xiaoyangxianshen664/CANopen_IO_Node/项目完成各阶段对应笔记/项目代码运行逻辑.md

# 13：项目代码运行逻辑

当然，我们再把**进入稳定运行后，代码实际上怎样循环**完整串一次。最重要的是：`CanopenTask` 和 `IOTask` 都不会一轮执行完就退出；它们都在 `for (;;)` 中循环，只是每轮会在延时或等待函数里让出 CPU。

### 1：`CanopenTask`每约 1 ms 循环一轮

优先级是 3，最高。每轮依次做四件事：

```c
① 处理 CAN 接收环形队列中的报文
② 有新采样时，取出 {DI, AI1, AI2} 并更新对象字典
③ 推进 Heartbeat 和 PDO 的定时处理
④ DO 值变化时，把 DO 字节放进 io_output_queue
```

随后调用 `vTaskDelayUntil()`，进入阻塞状态，等到下一个约 1 ms 的周期。时间到了，任务变为就绪，调度器安排它继续执行；从延时函数返回后，它回到 `for` 循环开头，开始下一轮。

```
四件事做完 → 延时到下一周期 → 恢复运行 → 回到第一件事
```

因此它是**每约 1 ms 开始新一轮**，不是每 1 ms 重新创建任务。每轮实际执行了多久目前没有测量。

### 2：`IOTask`等待通知或超时，然后继续循环

优先级是 2。每轮开头先清本地变量，再等待：

```
received_flags = 0u;
notified = xTaskNotifyWait(..., pdMS_TO_TICKS(10u));
```

执行到 `xTaskNotifyWait()` 时，若没有 ADC 通知，IOTask 会在这个函数里阻塞，最长 10 ms。之后有两种情况：

```c
//情况1
IOTask 正在运行
    ↓ 调用 xTaskNotifyWait，没有通知
进入阻塞态，等待通知或超时
    ↓ 通知到达 / 10 ms 超时
变为就绪态
    ↓ 调度器分配 CPU
回到运行态，xTaskNotifyWait 返回
    ↓ 
    → 计算对应半区的 AI1/AI2 平均值
    → 读取 DI
    → 把 {DI, AI1, AI2} 覆盖写入 io_sample_queue
	→ 处理DO
	
//情况2
10 ms 超时
    → 等待结束，但没有 ADC 新采样
    → 跳过 AI/DI 采样处理
    → 处理DO
```

两种情况之后都会继续检查 `io_output_queue`，取出 DO 值并调用 `apply_board_do()` 控制 LED。处理完到达 `for` 循环末尾后，**回到循环开头**，再次清零 `received_flags`，再次等待。

所以：

- DMA 半区完成约每 32 ms 通知一次，这是 ADC 数据处理的节奏；
- 10 ms 是一次通知等待的最长时间，超时后也会继续检查 DO 队列；
- `IOTask` 没有固定的 1 ms 或 32 ms 任务周期。

### 3：ADC、DMA 与中断在后台做什么

TIM3 每 1 ms 触发 ADC 扫描 AI1、AI2。CPU 正在执行任务时，ADC 和 DMA 仍由硬件持续工作。

DMA 写满一个半区后产生中断。中断回调通知 IOTask 哪个半区已经完成。**通知会让 IOTask 变为就绪，但不一定马上运行**：如果此时优先级更高的 `CanopenTask` 正在运行，IOTask 要等 CanopenTask 延时或阻塞后再获得 CPU。通知会保留给 IOTask，没能立即运行不等于通知丢失。

### 4：两个低优先级任务

`MonitorTask` 和 `DiagnosticsTask` 优先级都是 1，每约 1 秒执行一次短暂检查，然后各自延时 1 秒。它们没有固定的 CPU 时段；只有优先级 3、2 的任务都没有就绪运行时，才轮到它们。没有就绪任务时，FreeRTOS 运行空闲任务。

Heartbeat 也不是一个独立任务：`CanopenTask` 每轮推进 Heartbeat 计时约 1 ms，默认 `0x1017:00=1000 ms`，计时到期才发送一帧。Node-ID 1 在 Operational 状态时，典型帧是 `0x701`，数据字节 `0x05`。

整体运行关系可以这样记：

```c
CanopenTask：四项协议/I-O协调工作 → 延时 → 回到循环开头
IOTask：等待通知或超时 → 处理 ADC/DI、检查 DO → 回到循环开头
DMA 中断：半区完成时通知 IOTask
Monitor/Diagnostics：低优先级周期检查
```

“通知到达”表示 IOTask 已经就绪；“获得 CPU”还要由调度器根据优先级和当前任务状态决定。

### 5：上位机操作时，代码是怎么执行的

##### 1：上位机发送 `01 01`，节点进入 Operational

这帧应是 **CAN-ID `0x000`，DLC=2，数据 `01 01`**：

```
data[0] = 0x01：NMT Start 命令
data[1] = 0x01：目标节点 Node-ID 1
```

运行路径是：

```c
上位机发送 NMT 帧
    ↓
CAN 硬件收到帧，触发 CAN RX 中断
    ↓
bsp_can.c 的 HAL_CAN_RxFifo0MsgPendingCallback()
    ↓
中断把帧放入软件环形队列，尽快退出
    ↓
CanopenTask 下一轮取出帧
    ↓
dispatch_frame()
    ↓
Canopen_App_NmtReceive()
    ↓
co_nmt_receive()
    ↓
节点状态改为 Operational
```

CAN 接收中断只把帧放进队列，**不在中断里执行 NMT 协议处理**。`CanopenTask` 每约 1 ms 检查接收队列，因此收到帧后会在它下一次取队列时处理。

进入 Operational 后，这轮任务接着调用 `Canopen_App_ProcessPdo(1u)`。PDO 服务发现节点刚进入 Operational，会先发送一次 TPDO1 和 TPDO2，公布当前输入状态。之后才按 PDO 规则处理输入变化和事件周期。

##### 2：按下 KEY1 或 KEY2，DI 如何上报

当前按键映射是：

```c
KEY1 = PA0 → DI bit0
KEY2 = PC13 → DI bit1
```

`Key.h` 标明按键按下为高电平。`read_board_di()` 读到引脚高电平时设置对应位：

```c
KEY1 按下 → DI = 0x01
KEY2 按下 → DI = 0x02
两键都按下 → DI = 0x03
```

不过按键本身**不会直接让 `IO_Task` 运行**。在当前这条代码路径里，`IO_Task` 是由 ADC DMA 半区完成通知唤醒的：

```c
TIM3 每 1 ms 触发 ADC 扫描
    ↓
DMA 写满一个半区，约 32 ms
    ↓
ADC DMA 回调通知 IOTask
    ↓
IOTask 计算 AI1/AI2 平均值，并读取此刻的按键电平
    ↓
把 {DI, AI1, AI2} 写入 io_sample_queue
```

比如你在两次采样之间按下 KEY1，下一次 DMA 半区完成后，`IO_Task` 读到 `DI=0x01`，再把这组 DI/AI 数据交给队列。

之后的路径是：

```c
CanopenTask 取出 io_sample_queue 中的 sample
    ↓
Canopen_App_UpdateInputs(sample.di, sample.ai1, sample.ai2)
    ↓
更新对象字典中的 DI、AI1、AI2
    ↓
Canopen_App_ProcessPdo(1u) 检查输入变化
    ↓
若处于 Operational 且 DI 变化，发送 TPDO1（节点1的 CAN-ID 0x181）
```

所以按键变化是**采样时读到的**，随后被写入对象字典；在 Operational 状态下，PDO 服务再据此决定是否发送 TPDO1。

完整链路：

```c
ADC DMA 回调通知 IOTask
    ↓
IOTask 采到新的 DI
    ↓
CanopenTask 从队列取出采样
    ↓
Canopen_App_UpdateInputs() 更新对象字典
    ↓
CanopenTask 调用 Canopen_App_ProcessPdo(1u)
    ↓
co_pdo_process() 将当前 DI 和上次记录的 last_di 比较
    ↓
DI 有变化且节点处于 Operational → 发送 TPDO1
    
//真正判断 DI 变化并发送 TPDO1 的是Canopen_App_ProcessPdo函数里面调用的 co_pdo_process()
remember_status() 只负责记录错误状态。按下和松开如果都被采样到，通常都会各产生一次 DI 状态变化上报。
```

##### 3：上位机发 DO 数据，让 LED 改变颜色

比如上位机发：

```c
CAN-ID = 0x201
DLC    = 1
DATA   = 0x01
```

`0x201` 是节点 1 的 RPDO1。数据 `0x01` 表示 DO 的 bit0 为 1。接收和执行路径是：

```c
CAN RX 中断将帧放入接收环形队列
    ↓
CanopenTask 取出帧并调用 dispatch_frame()
    ↓
Canopen_App_PdoReceive()
    ↓
co_pdo_receive() 检查节点处于 Operational、DLC 和数据是否合法
    ↓
把 DO 值写入对象字典 0x6200:01
    ↓
CanopenTask 调用 Canopen_App_GetOutputs() 读出 DO
    ↓
DO 值变化，写入 io_output_queue
    ↓
IO_Task 取出 outputs 并调用 apply_board_do()
    ↓
改变 LED GPIO
```

当前 LED 位映射是：

| DO 数据位 | LED  |
| --- | ---- |
| bit0 | 红 |
| bit1 | 绿 |
| bit2 | 蓝 |

LED 是低电平点亮，所以输出位为 1 时，代码传给对应 LED 宏的参数是 0。例如：

```c
DO = 0x01 → 红灯亮
DO = 0x02 → 绿灯亮
DO = 0x04 → 蓝灯亮
DO = 0x05 → 红灯和蓝灯亮
```

另外，`IO_Task` 检查 DO 队列是在等待 ADC 通知之后。它最多等 10 ms 就会继续检查队列，因此 DO 命令到 LED 有一点任务调度延迟；这不是 CAN 中断直接控制灯，而是 `CanopenTask` 更新对象字典，再经队列交给 `IO_Task` 控灯。

这三个动作可以浓缩为：

```c
NMT：CAN 帧 → CAN RX 中断入队 → CanopenTask → NMT 状态变化

按键：ADC DMA 通知 → IOTask 读 DI/AI → 采样队列 → CanopenTask 更新对象字典 → TPDO 上报

DO：RPDO CAN 帧 → CAN RX 中断入队 → CanopenTask 写对象字典 → 输出队列 → IOTask 控制 LED
```

6

## 14：阶段 9 可靠性与 EMCY 故障处理运行逻辑

阶段 8 说明了节点正常运行时，CANopenTask、IOTask、ADC/DMA 和对象字典如何协作。阶段 9 在这条主循环中加入了故障监视、EMCY 上报、安全输出和恢复处理。核心代码位于 `freertos_demo.c` 的 `process_reliability()`，由 `Canopen_Task` 周期调用。

### 1：看门狗何时启动、谁负责刷新

`main()` 完成 HAL、ADC、CAN 等硬件初始化后调用 `BSP_IWDG_Init()`，随后才进入 `freertos_demo()` 创建任务并启动调度器：

```c
main()
    ↓
硬件初始化、CAN_Config()
    ↓
BSP_IWDG_Init()          启动 IWDG
    ↓
freertos_demo()          读取上次复位原因、创建任务、启动调度器
    ↓
Monitor_Task()           检查任务计数，健康时调用 BSP_IWDG_Refresh()
```

当前 IWDG 使用分频系数 64、重装载值 1500，LSI 按约 32 kHz 估算时超时约 3 秒。`Monitor_Task` 每约 1 秒检查一次 `canopen_task_cycle_count` 和 `io_task_cycle_count`；只有两个计数相对上次都发生变化时，才刷新看门狗。若任务停止推进，监视任务不再喂狗，IWDG 超时后复位 MCU。

启动时，`freertos_demo()` 先读取 `RCC_FLAG_IWDGRST`：若上次复位由 IWDG 触发，就置位 `watchdog_reset_pending`；随后清除 RCC 复位原因标志，避免下次启动误读旧记录。`process_reliability()` 会尝试把这条复位记录作为 `CO_EMCY_ERROR_WATCHDOG_RESET` 上报。

### 2：可靠性处理在主循环中的位置

`Canopen_Task` 每轮先处理接收帧并更新 I/O 输入，然后调用 `process_reliability()`，之后再推进 Heartbeat 和 PDO：

```c
CAN RX 队列 → dispatch_frame()
    ↓
取最新 DI/AI 采样并更新对象字典
    ↓
process_reliability()       阶段 9 故障处理
    ↓
ProcessHeartbeat(1 ms)
    ↓
ProcessPdo(1 ms)
    ↓
读取 DO，值变化时交给 IOTask
```

因此可靠性逻辑不是独立任务，而是由优先级较高的 `Canopen_Task` 周期执行。它每次调用只检查一次当前状态；恢复计数每次加一，按 CanopenTask 约 1 ms 的调用节奏近似累计毫秒数。

### 3：故障来源与“新故障”检测

CAN 驱动维护累计计数：

| CAN 驱动计数 | 表示什么 | 可靠性处理用途 |
| --- | --- | --- |
| `can_bus_off_count` | Bus-off 事件累计次数 | 检测新的 Bus-off，并启动接收恢复等待 |
| `can_rx_overflow_count` | 接收软件队列溢出次数 | 检测新的接收溢出 |
| `can_error_count` | HAL CAN 错误累计次数 | 检测新的 CAN 错误 |
| `can_rx_frame_count` | 收到的 CAN 帧累计数 | Bus-off 后确认是否收到新帧 |
| `can_tx_busy_count` | 发送邮箱全忙次数 | 供诊断快照查看；当前 `process_reliability()` 不用它触发故障 |

`observed_*_count` 保存 `process_reliability()` 上次看到的三个错误计数。每轮将当前累计值与它们比较，形成 `new_bus_off`、`new_rx_overflow`、`new_can_error`：计数不同则本轮标志为 1，相同则为 0；比较后再把当前值存回 `observed_*_count`，避免同一次计数变化在后续每轮重复识别。

`freertos_diagnostics_*` 是 `Diagnostics_Task` 每约 1 秒复制的诊断快照，不是 `process_reliability()` 用来发现新故障的比较基准。

### 4：发现故障、进入 EMCY 和安全输出

故障处理大致按以下顺序选择新故障：

```c
看门狗复位待上报
    ↓
新的 Bus-off
    ↓
新的 CAN 接收溢出
    ↓
新的 CAN 错误
    ↓
I/O 采样停滞
```

CAN/ADC 新故障通过 `Canopen_App_ReportEmcy()` 交给 `co_emcy_report()`，组帧并尝试发送。若 CAN 发送暂时失败，EMCY 模块保存 `pending_frame`，后续由 `Canopen_App_ProcessEmcy()` → `co_emcy_process()` 重试。

`reliability_fault_active` 是 FreeRTOS 可靠性流程的本地状态：非零表示正在执行故障处理、安全输出和恢复检查；它不代表 EMCY 帧一定已成功发送，也不等同于 EMCY 模块内部的 `emcy.active`。检测到 Bus-off 时，另外设置 `reliability_wait_for_rx` 并保存 `reliability_rx_baseline`，要求恢复时收到新的 CAN 帧。

活动故障期间的输出路径是：

```c
process_reliability()
    ↓
Canopen_App_SetSafeOutput(1)
    ↓
Canopen_Task 调用 Canopen_App_GetOutputs()
    ↓
安全状态下输出值为 0，写入 io_output_queue
    ↓
IOTask 取出输出值并调用 apply_board_do()
    ↓
真实 LED/DO 进入安全状态
```

每轮故障处理中都会调用 `Canopen_App_ProcessEmcy()`。它只重试 EMCY 模块中确实处于 pending 的帧；若之前的报告帧已成功发送且没有待重试帧，就不会重复发送。

### 5：恢复条件与清除 EMCY

本轮基本健康条件要求：`io_sampling_stalled == 0`，且本轮没有新的 Bus-off、接收溢出或 CAN 错误。若 `reliability_wait_for_rx` 置位，还要求 `can_rx_frame_count` 已高于 Bus-off 时记录的 `reliability_rx_baseline`。此外，节点必须处于 CANopen Operational 状态。

所有条件满足时，`reliability_recovery_ms` 每次调用加一；任何条件中断或节点离开 Operational，计数清零。达到 `FAULT_RECOVERY_STABLE_MS`（当前为 1000）后，调用 `Canopen_App_ClearEmcy()` 尝试发送清除帧。代码认为返回 `CO_OK` 或 `CO_IGNORED` 时清除本地可靠性故障状态，并调用 `Canopen_App_SetSafeOutput(0)` 解除安全输出。

恢复过程可以概括为：

```c
检测新故障
    ↓
报告 EMCY，启动可靠性故障状态
    ↓
强制安全输出，并处理 EMCY 待重试帧
    ↓
I/O、CAN 和 NMT 状态满足健康条件
    ↓
连续稳定计时达到 1000 次调用
    ↓
尝试发送 EMCY 清除帧
    ↓
清除本地故障状态，解除安全输出
```

### 6：阶段9实机验证结果与当前边界

- `Monitor_Task` 已增加首次运行宽限：第一次检查只记录采样基准，不把启动阶段尚未推进的计数判为停滞；之后约每秒更新一次 `io_sampling_stalled`。
- 阶段9使用 `FREERTOS_EMCY_TEST_INJECT_WATCHDOG` 宏做了一次受控看门狗故障注入。测试固件实测收到 `0x081 / 06 FF 01 00 00 00 00 00`，故障期间安全输出生效；进入 Operational 并稳定运行后收到 `0x081 / 00 00 00 00 00 00 00 00`，红灯恢复。随后关闭宏并重新烧录正式固件，正常启动不再自动上报 EMCY。
- 故障上报分支以 `status != CO_ERR_ARGUMENT` 判断是否启动可靠性处理；这不等于 EMCY 帧已经成功发送，发送失败时仍由 `pending_frame` 和 `Canopen_App_ProcessEmcy()` 重试。该主链路已由纯 C 测试和看门狗实机注入验证。
- `co_emcy_clear()` 在清除帧已处于 pending 时返回 `CO_IGNORED`，当前 `process_reliability()` 将 `CO_IGNORED` 也作为清除完成处理；清除帧失败重试的协议状态已在纯 C 测试覆盖，但该安全输出边界仍是后续可改进项。
- `reliability_recovery_ms` 是按任务调用次数计数，不是硬件定时器测得的精确毫秒数；`Canopen_Task` 延迟或超期时，实际稳定时间会有偏差。
- `process_reliability()` 通过优先级分支一次选择一种新故障；当前没有同时保存多个独立故障的故障队列。Bus-off、FIFO 溢出和 ADC 停滞没有通过破坏硬件逐项注入，属于阶段10可继续扩展的异常验收项。
