xiaoyangxianshen664/CANopen_IO_Node/项目完成各阶段对应笔记/阶段5/阶段5（sdo_.h）.md

# 解析：

这些 `#define` 是阶段 5 的 **SDO 固定常量**，用于统一表示响应 CAN-ID 和各类 SDO 命令字。

### 1：第一个宏定义

```c
#define CO_COB_SDO_TX_BASE UINT32_C(0x580)	//CO_COB_SDO_TX_BASE = 0x580
```

这是 SDO 响应的基准 COB-ID。

SDO 响应 CAN-ID 的计算方式是：

```
0x580 + Node-ID
```

例如：

```
Node-ID = 1 → 响应 ID = 0x581
Node-ID = 2 → 响应 ID = 0x582
Node-ID = 127 → 响应 ID = 0x5FF
```

代码中：

```
response.id = CO_COB_SDO_TX_BASE + sdo->node->node_id;
```

也就是：

```
response.id = 0x580 + node_id;
```

阶段 1 已经定义了 SDO 请求基准：

```
#define CO_COB_SDO_RX_BASE UINT32_C(0x600)
```

因此 SDO 的方向是：

```
主站 → 节点：0x600 + Node-ID
节点 → 主站：0x580 + Node-ID
```

Node-ID 为 1 时：

```
请求：0x601
响应：0x581
```

`UINT32_C(0x580)` 用于明确把常量写成适合 `uint32_t` 的整数类型。

### 2：读取请求

```c
#define CO_SDO_CMD_UPLOAD 0x40u	//主站请求节点读取一个对象。
```

例如主站读取：

```
0x1017:00
```

请求帧数据：

```
40 17 10 00 00 00 00 00
```

其中：

```
40       读取请求
17 10    Index = 0x1017，小端排列
00       Sub-index = 0x00
后四字节 读取请求没有携带对象数据，填 0
```

这里的 Upload 可以理解为：

```c
节点把对象数据“上传”给主站
```

### 3：写入请求

Download 表示：

> 主站把数据写入节点对象。

四个命令分别对应写入 1～4 个有效数据字节：

```c
#define CO_SDO_CMD_DOWNLOAD_1 0x2Fu
#define CO_SDO_CMD_DOWNLOAD_2 0x2Bu
#define CO_SDO_CMD_DOWNLOAD_3 0x27u
#define CO_SDO_CMD_DOWNLOAD_4 0x23u
```

对应关系：

| 命令字 | 写入有效数据长度 |
| --- | --- |
| `0x2F` | 1 字节 |
| `0x2B` | 2 字节 |
| `0x27` | 3 字节 |
| `0x23` | 4 字节 |

例如写入：

```
0x1017:00 = 500
```

500 的小端字节是：

```
F4 01
```

请求帧为：

```
2B 17 10 00 F4 01 00 00
```

含义：

```c
2B       写入 2 字节
17 10    Index = 0x1017
00       Sub-index = 0
F4 01    有效数据 500
00 00    剩余填充字节
```

为什么 `0x2B` 表示 2 字节，可以简单记忆为：

```c
0x2F → 1 字节
0x2B → 2 字节
0x27 → 3 字节
0x23 → 4 字节
```

这些命令字不仅表示“这是 Download”，还告诉服务层本次提供了几个有效数据字节。`co_sdo_receive()` 中就是通过它们设置：

```c
requested_length = 1u;
requested_length = 2u;
requested_length = 3u;
requested_length = 4u;
```

然后和对象条目的真实长度比较。

### 4：读取成功响应

```c
#define CO_SDO_CMD_UPLOAD_1 0x4Fu
#define CO_SDO_CMD_UPLOAD_2 0x4Bu
#define CO_SDO_CMD_UPLOAD_3 0x47u
#define CO_SDO_CMD_UPLOAD_4 0x43u
```

这些命令表示：

> 节点读取对象成功，并返回 1～4 个字节。

对应关系：

| 响应命令字 | 返回有效数据长度 |
| --- | --- |
| `0x4F` | 1 字节 |
| `0x4B` | 2 字节 |
| `0x47` | 3 字节 |
| `0x43` | 4 字节 |

例如读取：

```
0x1017:00 = 1000
```

1000 的小端形式是：

```
E8 03
```

响应帧：

```
4B 17 10 00 E8 03 00 00
```

含义：

```
4B       读取成功，返回 2 字节
17 10    Index = 0x1017
00       Sub-index = 0
E8 03    返回值 1000
00 00    未使用位置填 0
```

代码中通过对象长度选择响应命令：

```
response.data[0] = upload_command(entry->length);
```

如果对象长度是：

```
1 → 0x4F
2 → 0x4B
3 → 0x47
4 → 0x43
```

例如：

```
0x6200:01 是 UNSIGNED8，长度 1
```

读取响应命令就是：

```
0x4F
```

而：

```
0x1017:00 是 UNSIGNED16，长度 2
```

读取响应命令就是：

```
0x4B
```

### 5：写入成功响应

```c
#define CO_SDO_CMD_DOWNLOAD_OK 0x60u
```

`0x60` 表示：

> 主站写入对象成功，节点已经接受并完成写入。

例如主站写入 `0x1017:00 = 500`：

请求：

```
2B 17 10 00 F4 01 00 00
```

成功响应：

```
60 17 10 00 00 00 00 00
```

`0x60` 后面的 Index 和 Sub-index 用于说明这是对哪个对象的响应，后四字节没有额外数据，因此填 0。

### 6. Abort 响应

```
#define CO_SDO_CMD_ABORT 0x80u
```

`0x80` 表示：

> 本次 SDO 操作失败，后面跟随 4 字节 Abort 错误码。

例如读取不存在的对象：

```
0x9999:00
```

响应可能是：

```
80 99 99 00 00 00 02 06
```

拆开看：

```
80          Abort 命令字
99 99       Index = 0x9999
00          Sub-index = 0
00 00 02 06 Abort code = 0x06020000
```

因为错误码也按小端排列：

```
0x06020000 → 00 00 02 06
```

常见错误码包括：

```
0x06020000：Index 不存在
0x06090011：Sub-index 不存在
0x06010002：对象只读，不能写
0x06070012：数据过长
0x06070013：数据过短
0x06090030：值超出允许范围
0x08000022：当前 NMT 状态不允许
```

所以：

```
0x80
```

只是说明“失败”，真正的原因在后面的 4 字节 Abort code 中。

### 7. 这些宏在代码中的整体关系

```
主站发送请求
    │
    ├── 0x40：读取对象
    ├── 0x2F：写 1 字节
    ├── 0x2B：写 2 字节
    ├── 0x27：写 3 字节
    └── 0x23：写 4 字节
    │
    ▼
节点解析并访问对象字典
    │
    ├── 读取成功
    │      ├── 0x4F：返回 1 字节
    │      ├── 0x4B：返回 2 字节
    │      ├── 0x47：返回 3 字节
    │      └── 0x43：返回 4 字节
    │
    ├── 写入成功
    │      └── 0x60
    │
    └── 操作失败
           └── 0x80 + Abort code
```

可以用一句话记忆：

```
0x40 是读请求；
0x2F/2B/27/23 是按长度区分的写请求；
0x4F/4B/47/43 是按长度区分的读成功响应；
0x60 是写成功；
0x80 是 Abort 失败响应。
```

这些宏本身不会发送报文，也不会访问对象。它们只是把协议中固定的数字命令定义成有名字的常量，让 `co_sdo.c` 里的逻辑更容易阅读和维护。

# 结构体

```c
typedef struct
{
    co_context_t *node;
    co_device_od_t *device;
} co_sdo_t;
```

它本身只是定义类型，真正的变量由调用者创建，例如测试中的：

```
co_sdo_t sdo = {0};
```

之后通过：

```
co_sdo_init(&sdo, &node, &device);
```

完成绑定。

## 1. `co_context_t *node`的作用

```
co_context_t *node;
```

这是指向节点上下文的指针。

例如：

```
co_context_t node = {0};
co_sdo_t sdo = {0};

co_sdo_init(&sdo, &node, &device);
```

初始化后：sdo.node ─────► node

```c
co_status_t co_sdo_init(co_sdo_t *sdo,
                        co_context_t *node,
                        co_device_od_t *device)
{
    co_sdo_t candidate = {node, device};
    co_status_t status;

    if (sdo == NULL)
        return CO_ERR_ARGUMENT;

    status = validate(&candidate);
    if (status != CO_OK)
        return status;

    *sdo = candidate;
    return CO_OK;
}

先看测试中创建的三个实际变量：
co_context_t node = {0};
co_device_od_t device = {0};
co_sdo_t sdo = {0};
它们分别是：
node    一个实际的节点结构体变量
device  一个实际的设备对象字典变量
sdo     一个实际的 SDO 结构体变量

然后调用：
co_sdo_init(&sdo, &node, &device);
这里传入的是三个地址：
    
&sdo    				sdo 变量的地址
&node   			    node 变量的地址
&device                  device 变量的地址

所以函数参数实际对应：
co_sdo_t        *sdo   = &sdo;
co_context_t    *node  = &node;
co_device_od_t  *device = &device;

可以先忽略类型，只看名字：
sdo    参数 → 指向外面的 sdo 变量
node   参数 → 指向外面的 node 变量
device 参数 → 指向外面的 device 变量

第一步：创建临时的 candidate
co_sdo_t candidate = {node, device};
co_sdo_t 结构体有两个成员：

 typedef struct
{
    co_context_t *node;
    co_device_od_t *device;
} co_sdo_t;
所以这句等价于：
co_sdo_t candidate;

candidate.node = node;
candidate.device = device;
而函数参数中的：
node   实际是 &node
device 实际是 &device
所以最终就是：
candidate.node   = &node;
candidate.device = &device;
此时关系是：
candidate
├── node   ─────► 外面的 node 变量
└── device ────► 外面的 device 变量
    
//bb 那么多话，其实就是传的实参node 是一个地址指针，node 存的东西是node=&node，这jb codex 这么写代码也是神了
co_sdo_t 结构体两个子变量就是存指针，
分别存的&node 和&device 呗
```

它让 SDO 服务能够访问：

```
node->node_id
node->state
node->tx
node->tx_user
```

##### 用于计算响应 CAN-ID

SDO 响应的 CAN-ID 是：

```
0x580 + Node-ID
```

代码中：

```
response.id = CO_COB_SDO_TX_BASE + sdo->node->node_id;
```

假设：

```
Node-ID = 1
```

响应 ID 就是：

```
0x580 + 1 = 0x581
```

假设：

```
Node-ID = 2
```

响应 ID 就是：

```
0x580 + 2 = 0x582
```

因此 SDO Server 不需要固定写死 `0x581`，而是通过 `node` 指针读取当前节点号。

##### 用于状态门控

SDO 是否处理，还要看当前 NMT 状态：

```
if (kind != CO_RX_SDO || !active(sdo->node->state))
    return CO_IGNORED;
```

`active()` 只允许：

```
CO_NMT_PRE_OPERATIONAL
CO_NMT_OPERATIONAL
```

因此：

```
Initialization → 忽略 SDO
Pre-operational → 处理 SDO
Operational → 处理 SDO
Stopped → 忽略 SDO
```

这体现了 `node` 指针的第二个作用：

> SDO 根据节点当前 NMT 状态决定是否提供服务。

##### 用于发送响应

生成响应帧后：

```
return co_send(sdo->node, &response);
```

这里通过节点上下文调用阶段 1 的统一发送入口，最终进入：

```
node->tx(node->tx_user, &response)
```

所以 `node` 把阶段 5 SDO 和阶段 1 的发送机制连接起来。

## 2. `co_device_od_t *device`的作用

```
co_device_od_t *device;
```

这是指向设备对象字典的指针。

例如：

```
co_device_od_t device = {0};
co_sdo_t sdo = {0};

co_sdo_init(&sdo, &node, &device);
```

初始化后：

```
sdo.device ─────► device
```

它让 SDO 服务可以通过对象字典查找和访问对象。

##### 用于查找对象

收到请求后，SDO 从报文中解析：

```
Index
Sub-index
```

然后调用：

```
co_od_find(&device->table, index, subindex, &entry);
```

在 SDO 代码中实际通过：

```
find_entry(sdo->device, index, subindex, &entry, &abort_code);
```

查找例如：

```
0x1017:00
0x6200:01
0x6401:01
```

找到后：

```
entry ─────► 对象条目
```

##### 用于读取对象

Upload 请求 `0x40` 找到对象后：

```
status = co_od_read(entry, data, entry->length);
```

对象层通过条目的回调，把当前对象值读入：

```
uint8_t data[4];
```

例如：

```
0x1017:00 = 1000
```

读取后：

```
data[0] = 0xE8
data[1] = 0x03
```

然后 SDO 将这些字节放入响应帧。

##### 用于写入对象

Download 请求找到对象后：

```
status = co_od_write(entry,
                     sdo->node->state,
                     request->data + 4u,
                     requested_length);
```

这里把：

```
请求帧 Data[4..7]
```

作为对象数据交给阶段 2 的对象写入层。

例如：

```
请求：
2B 17 10 00 F4 01 00 00
```

传给对象层的是：

```
request->data + 4
    ↓
F4 01
```

对象层最终把它写入：

```
0x1017:00 = 500
```

##### 用于把内部错误转换为 Abort

对象层返回的是内部状态：

```
CO_ERR_OD_NOT_FOUND
CO_ERR_OD_READ_ONLY
CO_ERR_OD_LENGTH
CO_ERR_OD_VALUE
CO_ERR_OD_STATE
```

SDO 服务再把它们转换为 CANopen Abort 码：

```
CO_ERR_OD_NOT_FOUND → 0x06020000
CO_ERR_OD_READ_ONLY → 0x06010002
CO_ERR_OD_LENGTH    → 0x06070010 / 12 / 13
CO_ERR_OD_VALUE     → 0x06090030
CO_ERR_OD_STATE     → 0x08000022
```

所以：

```
阶段 2：返回程序内部错误状态
阶段 5：把内部错误包装成 SDO Abort 响应
```
