xiaoyangxianshen664/CANopen_IO_Node/项目完成各阶段对应笔记/阶段9/canopen_app状态机.md

# 一、先抓住 `canopen_app.c` 的本质

你可以把它理解成：

```c
                 CanopenTask / IO_Task
                         │
                         ▼
                ┌─────────────────┐
                │  canopen_app.c  │
                │   应用层接口     │
                └────────┬────────┘
                         │
             转交给纯 C CANopen 模块
                         │
        ┌────────────────┼────────────────┐
        ▼                ▼                ▼
      co_nmt           co_sdo            co_pdo
        │                │                │
     节点状态          对象字典          PDO通信
                         
                         │
                         ▼
                      co_hb
                      co_emcy
```

所以最重要的一句话就是：

> `canopen_app.c` 自己不是 CANopen 协议核心，它主要负责“把协议层的事情交给对应的 `BSP层` 模块”。

# 二、5 类函数，其实可以进一步压成 5 个动作

你原来的分类非常好，我建议最终记成：

```c
① Init       —— 建立
② Receive    —— 接收
③ Process    —— 推进
④ Update/Get —— 搬运数据
⑤ Report/Clear —— 故障处理
```

------

### ① Init：把整个系统接起来

```c
Canopen_App_Init()
```

它做的是：

```c
node
device
nmt
heartbeat
sdo
pdo
emcy
   ↓
全部初始化
   ↓
CANopen 节点准备运行
```

所以看到：

```
Init
```

就想到：

> **“把所有 CANopen 模块组装起来。”**

# 三、 Receive：主站发东西过来

这里非常重要，因为三个 Receive 可以用**主站发什么**来记。

```v
主站
 │
 ├── NMT ──→ NmtReceive
 │
 ├── SDO ──→ SdoReceive
 │
 └── RPDO ─→ PdoReceive
```

### NMT

```v
Canopen_App_NmtReceive()
        ↓
co_nmt_receive()
        ↓
node.state
```

一句话：

> **NMT = 改节点状态**

------

### SDO

```c
Canopen_App_SdoReceive()
        ↓
co_sdo_receive()
        ↓
对象字典
        ↓
SDO Response
```

一句话：

> **SDO = 主站访问对象字典**

------

### RPDO

```c
Canopen_App_PdoReceive()
        ↓
co_pdo_receive()
        ↓
0x6200:01
```

一句话：

> **RPDO = 主站下发输出数据**

所以三个 Receive 不要死背：

```c
NMT → 主机要求nmt状态改变
SDO → 主机访问字典读取值DI，AI1,AI2
RPDO → 主机输出DO至字典
```

# 四、 Process：不是“收到东西”，而是“时间到了，该干活了”

这是和 Receive 最容易混淆的地方。

### Heartbeat

```c
Canopen_App_ProcessHeartbeat(1u)
```

本质：

```c
时间推进
   ↓
Heartbeat 定时器
   ↓
到期？
   ↓
发送 0x700 + Node-ID
```

所以：

> **Heartbeat Process = 推进心跳定时器。**

------

### PDO

```
Canopen_App_ProcessPdo(1u)
```

本质：

```c
对象字典中的 DI/AI
        ↓
有没有变化？
有没有到周期？
        ↓
决定是否发送 TPDO
```

所以：

> **PDO Process = 推进 PDO 处理，并决定要不要上报输入。**

------

因此：

```c
Receive
    ↓
“别人发东西给我”

Process
    ↓
“我自己周期性检查该做什么”
```

这个区别一定要记住。

# 五、Update / Get：数据搬运桥

这个其实是整个应用层最容易理解的一组。

### UpdateInputs

```c
真实硬件
   │
   │ IO_Task
   ▼
DI / AI
   │
   ▼
Canopen_App_UpdateInputs()
   │
   ▼
对象字典
```

对应：

```c
DI  → 0x6000:01
AI1 → 0x6401:01
AI2 → 0x6401:02
```

注意：

> **UpdateInputs 只是更新数据，不负责发送 TPDO。**

之后：

```
UpdateInputs()
      ↓
ProcessPdo()
      ↓
决定是否 TPDO
```

这两个函数要绑定记忆。

------

### GetOutputs

方向刚好反过来：

```c
对象字典
   ↓
GetOutputs()
   ↓
outputs
   ↓
io_output_queue
   ↓
IO_Task
   ↓
真实 DO
```

所以：

```c
UpdateInputs = 外部 → CANopen

GetOutputs   = CANopen → 外部
```

这是非常漂亮的一对：

> **Input 是“写进去”，Output 是“拿出来”。**

# 六、 EMCY：故障三件套

这里你其实已经理解得很好。

直接记：

```c
Report
   ↓
新故障

Clear
   ↓
故障恢复

Process
   ↓
发送失败，重试
```

即：

```c
Canopen_App_ReportEmcy()
        ↓
co_emcy_report()

Canopen_App_ClearEmcy()
        ↓
co_emcy_clear()

Canopen_App_ProcessEmcy()
        ↓
co_emcy_process()
```

最关键的区别：

### Report 不负责“发现故障”

而是：

```c
其他模块发现故障
        ↓
ReportEmcy()
        ↓
EMCY 模块组装报文
        ↓
发送
```

### Clear 不负责“判断是否恢复”

而是：

```c
外部可靠性逻辑判断已经恢复
        ↓
ClearEmcy()
```

### Process 不负责“产生故障”

它只是：

```c
pending=1时
 ↓
重新发送
```

# 七、把整个 `canopen_app.c` 串起来

现在可以把它压缩成下面这一张图：

```c
                     CANopen_App
                          │
       ┌──────────────────┼──────────────────┐
       │                  │                  │
      主站                周期任务             硬件
       │                  │                  │
       ▼                  ▼                  ▼
   Receive              Process          UpdateInputs
       │                  │                  │
 ┌─────┼─────┐       ┌────┴────┐            │
 ▼     ▼     ▼       ▼         ▼            ▼
NMT   SDO   RPDO   Heartbeat   PDO        DI / AI
 │     │     │       │         │            │
 ▼     ▼     ▼       ▼         ▼            ▼
状态  字典   DO     心跳       TPDO       对象字典
                                              │
                                              ▼
                                         ProcessPdo
                                              │
                                              ▼
                                             TPDO

对象字典
    │
    ▼
GetOutputs()
    │
    ▼
DO
    │
    ▼
IO_Task
    │
    ▼
真实硬件

故障
 │
 ├── ReportEmcy()
 │
 ├── ProcessEmcy()
 │
 └── ClearEmcy()
```

# 八、最后给你一个真正适合背的版本

以后你重新打开 `canopen_app.c`，脑子里只需要先出现：

```c
canopen_app.c
│
├── Init
│   └── 初始化节点、对象字典和各协议模块，发送 Boot-up
│
├── Receive：处理主站发来的报文
│   ├── NMT  → 改变节点状态
│   ├── SDO  → 读写对象字典
│   └── RPDO → 写入 DO 对象
│
├── Process：推进协议服务
│   ├── Heartbeat → 到期时发送当前 NMT 状态
│   └── PDO       → 检查变化/周期，发送 TPDO
│
├── Data Bridge：连接真实 I/O 和对象字典
│   ├── UpdateInputs → DI/AI 写入对象字典
│   └── GetOutputs   → 从对象字典读取 DO；故障或非 Operational 时返回安全值DO恒为0
│
└── EMCY：故障处理接口
    ├── Report  → 报告新故障
    ├── Clear   → 报告故障已恢复
    └── Process → 重试发送失败的 EMCY 帧
特别是输出方向要连着理解：RPDO 先更新 DO 对象，GetOutputs 再取出 DO 值交给 FreeRTOS 任务输出到 GPIO。
```

然后再加一条**最核心的方向感**：

```c
主站 → 节点
NMT / SDO / RPDO
        ↓
     Receive

//按按键或者拧电位器
硬件 → CANopen
DI / AI
  ↓
UpdateInputs
  ↓
对象字典
  ↓
ProcessPdo
  ↓
TPDO
  ↓
主站

//can上位机下发东西
主站 → CANopen → 硬件
RPDO
 ↓
PdoReceive
 ↓
对象字典
 ↓
GetOutputs
 ↓
IO_Task
 ↓
DO
```
