xiaoyangxianshen664/CANopen_IO_Node/项目完成各阶段对应笔记/阶段5/阶段5.md

阶段 5 的首版代码已经写完，并创建了本地分支：

```
stage5-sdo
```

新增：

- [co_sdo.h](C:/Users/lolbo/CANopen_IO_Node/canopen/include/co_sdo.h)
- [co_sdo.c](C:/Users/lolbo/CANopen_IO_Node/canopen/src/co_sdo.c)
- [test_co_sdo.c](C:/Users/lolbo/CANopen_IO_Node/tests/test_co_sdo.c)

更新：

- [canopen/CMakeLists.txt](C:/Users/lolbo/CANopen_IO_Node/canopen/CMakeLists.txt)
- [tests/CMakeLists.txt](C:/Users/lolbo/CANopen_IO_Node/tests/CMakeLists.txt)

当前实现包括：

```
SDO 请求：0x600 + Node-ID
SDO 响应：0x580 + Node-ID
固定 DLC：8
Upload：0x40
Download：0x2F / 0x2B / 0x27 / 0x23
Upload 响应：0x4F / 0x4B / 0x47 / 0x43
Download 成功：0x60
Abort：0x80 + 4 字节错误码
```

已覆盖：

- 读取 `0x1017:00`；
- 写入 `0x1017:00`；
- 不存在的 Index；
- 存在 Index 但不存在的 Sub-index；
- 只读对象写入；
- 数据长度过短；
- BOOLEAN 非法值；
- 不支持的命令；
- Initialization/Stopped 状态忽略 SDO；
- 错误 Abort 码按小端返回；
- 通过阶段 1 的 `co_send()` 发送响应。

验证结果：

```
cmake --build build                         通过
ctest --test-dir build --output-on-failure  14/14 通过
git diff --check                            通过
```

我暂时没有创建 commit，因为我们之前约定是先把当前阶段的 `.c/.h` 和测试全部写完并验证，再按源码主线学习，最后更新笔记并提交。当前无关的 `pelican-bicycle-animation.html` 仍未纳入修改。
