xiaoyangxianshen664/CANopen_IO_Node/项目完成各阶段对应笔记/阶段4/阶段4.md

```
当前实现覆盖：
- 从 0x1017:00 读取 Heartbeat 周期；
- 周期为 0 时关闭 Heartbeat；
- 到期发送 0x700 + Node-ID；
- DLC 为 1；
- 数据字节为当前 NMT 状态；
- Initialization 状态不发送周期 Heartbeat，避免把 Boot-up 的 0x00 当作普通心跳；
- 发送失败后保留到期状态，下一次可重试；
- 同值重写 0x1017 也会重新开始计时；
- 保留周期余量，避免计时漂移。
```
