xiaoyangxianshen664/CANopen_IO_Node/项目完成各阶段对应笔记/阶段2/阶段2（co_od.h）.md

# 解析

### 1：第一个枚举

```c
typedef enum {
    CO_OD_UNSIGNED8 = 1, /* 无符号 8 位整数，占 1 字节 */
    CO_OD_UNSIGNED16 = 2, /* 无符号 16 位整数，占 2 字节 */
    CO_OD_UNSIGNED32 = 4 /* 无符号 32 位整数，占 4 字节 */
} co_od_type_t;
```

这是定义一个枚举类型，用来描述对象字典中的无符号整数类型。

```c
co_od_type_t		//是这个枚举类型的名字。
```

三个枚举成员分别表示：

| 枚举值 | 含义 | 占用字节数 |
| --- | --- | --- |
| `CO_OD_UNSIGNED8`  | UNSIGNED8  | 1 |
| `CO_OD_UNSIGNED16` | UNSIGNED16 | 2 |
| `CO_OD_UNSIGNED32` | UNSIGNED32 | 4 |

这里的数值：

```
1、2、4
```

是我们有意设置的，直接对应该类型需要的**字节数**。

例如对象条目中：

```
.type = CO_OD_UNSIGNED16
```

表示这个对象使用 `UNSIGNED16` 类型。

后面程序就可以根据这个枚举值判断它应该占几个字节：

```
CO_OD_UNSIGNED8  → 1 字节
CO_OD_UNSIGNED16 → 2 字节
CO_OD_UNSIGNED32 → 4 字节
```

要注意，`CO_OD_UNSIGNED16` 不是 C 语言真正的 `uint16_t` 变量，它只是一个**类型描述标记**。

真正的数据变量可能是：

```
uint16_t analog_input;
```

而对象条目中的：

```
CO_OD_UNSIGNED16
```

只是告诉对象字典：

```
这个对象按照 UNSIGNED16 解释，占 2 字节。
```

例如：

```
co_od_type_t type = CO_OD_UNSIGNED16;
```

此时：

```
type 保存的是类型描述
实际数值仍然需要由读取回调提供
```

所以这组枚举解决的是：

```
对象是什么数据类型？
对象应占多少字节？
```

暂时不涉及对象当前具体保存的数值。

### 2：第二个枚举

```c
typedef enum {
    CO_OD_READ_ONLY = 0,
    CO_OD_READ_WRITE = 1
} co_od_access_t;
```

这个枚举描述对象字典的**访问权限**。

```c
co_od_access_t		//是枚举类型名称。
```

两个成员含义：

#### CO_OD_READ_ONLY = 0

```
CO_OD_READ_ONLY = 0
```

表示只读：

```c
主站can上位机可以读取对象
主站can上位机不能通过对象字典写入对象
```

例如：

```
0x6000:01 数字输入
0x6401:01 AI1
```

这些数据由 STM32 的输入引脚或 ADC 更新，主站只能读取。

#### CO_OD_READ_WRITE = 1

表示可读写：

```
主站可以读取对象
主站也可以通过对象字典写入对象
```

例如：

```
0x6200:01 数字输出命令
0x1017:00 心跳周期
```

主站可以写入新的值，协议层再通过写回调交给应用层处理。

这里的 `0` 和 `1` 只是权限标记：

```
0 → 只读
1 → 可读写
```

它们不是 CAN 报文中的数据，也不是对象当前保存的数值。

例如：

```
co_od_access_t access = CO_OD_READ_ONLY;
```

表示这个变量描述的是：

```
该对象允许怎样访问
```

后面对象条目会通过成员保存这个权限：

```
entry.access
```

当调用写入函数时，程序会检查：

```
if (entry->access != CO_OD_READ_WRITE)
```

如果对象是 `CO_OD_READ_ONLY`，就拒绝写入，并返回：

```
CO_ERR_OD_READ_ONLY
```

所以这个枚举解决的是：

```
这个对象允许主站读写，还是只能读取？
```

### 3：读（回调函数指针）

```c
typedef co_status_t (*co_od_read_fn)(
    void *user,
    uint8_t *data,
    uint8_t length
);
```

它表示：凡是符合这个参数和返回值形式的函数，都可以作为对象的读取函数。

拆开看：

```c
co_status_t
```

表示回调执行后返回一个状态，例如：

```c
CO_OK
CO_ERR_ARGUMENT
(*co_od_read_fn)
```

表示 `co_od_read_fn` 是一个**函数指针类型**。

```
void *user
```

是回调使用的辅助数据地址。

例如对象值可能保存在某个应用变量中，或者需要通过硬件读取。对象字典本身不直接知道这些数据在哪里，就通过 `user` 把相关对象地址传给回调。

```
uint8_t *data
```

是输出数据缓冲区的地址。

读取回调要把对象当前值写进这里。例如 AI1 当前值是：

```
0x1234
```

按照 CANopen 小端顺序写入：

```
data[0] = 0x34
data[1] = 0x12

```

uint8_t length表示这次要写入多少个字节。

例如：

```
UNSIGNED8  → length = 1
UNSIGNED16 → length = 2
UNSIGNED32 → length = 4
```

一个符合它的读取函数可以是：

```c
static co_status_t my_read(void *user,
                           uint8_t *data,
                           uint8_t length)
{
    /* 把对象当前值写入 data */
    return CO_OK;
}
```

### 4：写（回调函数指针）

```c
typedef co_status_t (*co_od_write_fn)(
    void *user,
    const uint8_t *data,
    uint8_t length
);
```

它和读取回调很相似，但 `data` 前面多了：

```
const
```

这里的 `data` 是主站传进来的写入数据，回调只应该读取它，不能修改它。

例如主站要把数字输出写成：

```
0x05
```

对象字典完成检查后调用写回调：

```
write(user, data, 1);
```

写回调读取：

```
data[0] == 0x05
```

然后把这个值交给应用层，控制对应的 DO。

### 5：两个回调的区别

##### 1：区别

这两个回调的方向可以这样记：

```c
读取对象：

应用层当前值
      ↓
read 回调
      ↓
data 缓冲区
      ↓
后续 SDO/PDO 使用

    写入对象：

主站数据
      ↓
data 缓冲区
      ↓
对象字典检查
      ↓
write 回调
      ↓
应用层变量或硬件
```

它们的区别是：

| 回调 | `data` 作用  | 是否允许回调修改 |
| --- | --- | --- |
| `co_od_read_fn`  | 输出缓冲区 | 可以写入 |
| `co_od_write_fn` | 主站输入数据 | 不可以修改 |

所以这两个函数指针类型的目的，是让对象字典只负责：

```
查找对象、检查权限、检查长度和数值
```

具体数据从哪里读取、写入哪个应用变量，则交给外部回调完成。

##### 2：补充

这两个都是**函数指针类型**，但有两点需要修正。

**读取回调：**

```c
typedef co_status_t (*co_od_read_fn)(
    void *user,
    uint8_t *data,
    uint8_t length
);
```

它用于读取 STM32 当前对象值，例如：

```
PA0～PA3 → 数字输入对象
PC0/PC1 → AI 对象
```

执行读取回调时，回调函数把当前值写入 `data`：

```c
STM32 当前数据
    ↓
读取回调
    ↓
data 缓冲区
    ↓
SDO 或 PDO
```

这里 `data` 可以修改的说法，是因为它是**输出缓冲区**。对象值会随着输入变化，所以每次读取时都可能得到不同的数据，所以说可修改，是指的是缓存区的内容可以修改。

**写入回调：**

```
typedef co_status_t (*co_od_write_fn)(
    void *user,
    const uint8_t *data,
    uint8_t length
);
```

它用于把主站写入对象的数据交给应用层，例如：

```c
主站写入 0x6200:01
    ↓
对象字典检查
    ↓
写入回调
    ↓
STM32 更新 DO 输出
```

`const uint8_t *data` 中的 `const` 表示：

```
回调可以读取主站发送的数据
回调不能修改 data 缓冲区本身
```

例如主站发送：

```
data[0] = 0x05
```

回调可以读取 `0x05`，然后让应用层控制对应输出，但不能把 `data[0]` 改成别的值。

不过“主机发送什么就原样写入”还要加一个前提：对象字典会先检查权限、长度和值范围。

例如数字输出允许范围是 `0～15`：

```
主站写 0x05 → 允许
主站写 0x10 → 拒绝
```

另外，写回调不一定都控制引脚；`0x1017:00` 这样的对象可能是写入心跳周期。核心区别是：

```
read 回调：把当前对象值写入输出缓冲区
write 回调：读取输入缓冲区，并更新应用层对象
```

### 6：对象记录结构体

```c
typedef struct {
    uint16_t index; /* 对象索引，例如 0x6200 */
    uint8_t subindex; /* 对象子索引，例如 0x01 */
    co_od_type_t type; /* 对象数据类型，同时决定标准长度 */
    co_od_access_t access; /* 主站的读写权限 */
    uint8_t length; /* 对象在 SDO/PDO 中占用的字节数 */
    uint32_t min_value; /* 写入值允许的最小值 */
    uint32_t max_value; /* 写入值允许的最大值 */
    uint8_t write_preop_only; /* 非零表示只允许 Pre-operational 状态写入 */
    co_od_read_fn read; /* 读取对象值的回调 */
    co_od_write_fn write; /* 写入对象值的回调；只读对象可为 NULL */
    void *user; /* 回调使用的应用层私有数据 */
} co_od_entry_t;
```

这个结构体表示对象字典中的**一条对象记录**。

可以把它理解成表格中的一行。例如：

```
0x6200:01 → 数字输出命令
```

这一行的全部信息，就放在一个 `co_od_entry_t` 变量中。

#### **① `index`：对象索引**

```
uint16_t index;
```

保存对象的 Index。

例如：

```
index = 0x6200;
```

`0x6200` 表示数字输出这一组对象。

它不是 CAN-ID，而是对象字典地址的一部分。

#### **② `subindex`：对象子索引**

```
uint8_t subindex;
```

保存这一组中的具体成员。

例如：

```
subindex = 0x01;
```

组合起来就是：

```
index + subindex
0x6200:01
```

表示数字输出命令这个具体对象。

#### **③ `type`：对象数据类型**

```
co_od_type_t type;
```

保存前面学过的类型描述：

```c
CO_OD_UNSIGNED8
CO_OD_UNSIGNED16
CO_OD_UNSIGNED32
```

例如：

```
type = CO_OD_UNSIGNED8;
```

表示这个对象按照 UNSIGNED8 解释。

#### **④ `access`：主站（上位机）访问权限**

```c
co_od_access_t access;
```

保存：

```
CO_OD_READ_ONLY
CO_OD_READ_WRITE
```

例如数字输出：

```
access = CO_OD_READ_WRITE;
```

表示主站可以读取，也可以写入。

数字输入：

```
access = CO_OD_READ_ONLY;
```

表示主站只能读取，不能写入。

#### **⑤ `length`：数据长度**

```
uint8_t length;
```

表示这个对象实际占用多少字节。

例如：

```
UNSIGNED8  → length = 1
UNSIGNED16 → length = 2
UNSIGNED32 → length = 4
```

例如：

```
type = CO_OD_UNSIGNED16;
length = 2;
```

对象字典会检查这两个描述是否一致，防止把一个 16 位对象错误地配置成 1 字节。

#### **⑥ `min_value`：允许的最小值**

```
uint32_t min_value;
```

表示主站写入时允许的最小数值。

数字输出可以设置：

```
min_value = 0;
```

模拟量也可以设置：

```
min_value = 0;
```

#### **⑦ `max_value`：允许的最大值**

```
uint32_t max_value;
```

表示主站写入时允许的最大数值。

例如数字输出只有 4 路，使用 bit0～bit3，因此可以设置：

```
max_value = 15;
```

因为：

```
0x0F = 二进制 0000 1111
```

如果主站写入 `0x10`，就超过允许范围，会返回：

```
CO_ERR_OD_VALUE
```

对于只读对象，这两个范围主要用于描述对象合法范围；写入检查只有在对象允许写入时才会真正触发。

#### **⑧ `write_preop_only`：是否只能在预运行状态写入**

```
uint8_t write_preop_only;
```

它是一个开关：

```
0 → 不要求 Pre-operational 状态
1 → 只有 Pre-operational 状态允许写入
```

例如 PDO 参数通常设置：

```
write_preop_only = 1;
```

当节点处于：

```
CO_NMT_PRE_OPERATIONAL
```

时允许修改。

如果节点处于：

```
CO_NMT_OPERATIONAL
```

则拒绝写入，返回：

```
CO_ERR_OD_STATE
```

#### **⑨ `read`：读取回调地址**

```
co_od_read_fn read;
```

保存这个对象的读取函数地址。

例如 `0x6000:01` 的读取回调可能去读取：

```
PA0～PA3 的数字输入状态
```

读取对象时，对象字典通过这个函数获得当前值。

#### **⑩ `write`：写入回调地址**

```
co_od_write_fn write;
```

保存这个对象的写入函数地址。

例如 `0x6200:01` 的写入回调可以：

```
读取主站写入的 1 字节数据
更新 DO 状态
控制 PB0～PB3
```

只读对象没有写入功能，所以：

```
write = NULL;
```

#### **⑪ `user`：回调辅助数据**

```
void *user;
```

保存传给回调的辅助数据地址。

例如：

```
uint8_t digital_output;
```

可以把它的地址保存到：

```
entry.user = &digital_output;
```

调用回调时：

```
entry.read(entry.user, data, entry.length);
```

回调就能通过 `user` 找到对应的应用变量。

这和前面阶段 1 的发送回调辅助参数是同一种思想。

**完整举例：数字输出对象**

```c
co_od_entry_t output_entry = {
    .index = 0x6200,
    .subindex = 0x01,
    .type = CO_OD_UNSIGNED8,
    .access = CO_OD_READ_WRITE,
    .length = 1,
    .min_value = 0,
    .max_value = 15,
    .write_preop_only = 0,
    .read = output_read,
    .write = output_write,
    .user = &digital_output
};
```

它完整描述了：

```
对象地址：0x6200:01
类型：UNSIGNED8
长度：1 字节
权限：可读写
合法范围：0～15
读取：调用 output_read
写入：调用 output_write
应用数据：由 digital_output 关联
```

所以 `co_od_entry_t` 就是对象字典中一条完整的“对象说明记录”。

### 7：对象字典表结构体

```c
typedef struct {
    const co_od_entry_t *entries;	 /* 对象条目数组地址 */
    size_t count;				 /* 数组中有效条目数 */
} co_od_table_t;
```

这个结构体表示一张**对象字典表**，它把多个对象条目组织在一起。

#### **① `entries`：对象条目数组地址**

```
const co_od_entry_t *entries;
```

它指向一个 `co_od_entry_t` 数组。

例如：

```c
const co_od_entry_t entries[] = {
    /* 0x6000:01 */
    /* 0x6200:01 */
    /* 0x6401:01 */
};
```

然后：

```
co_od_table_t table = {
    entries,
    3
};
```

此时：

```c
table.entries → entries[0]
               entries[1]
               entries[2]
```

`const` 表示对象字典查找函数只能读取这些条目，不能通过 `table.entries` 修改条目内容。

#### **② `count`：数组中有多少个有效条目**

```
size_t count;
```

它保存对象条目的数量。

例如：

```
count = 3;
```

表示数组中有：

```
entries[0]
entries[1]
entries[2]
```

共 3 条有效对象记录。

`size_t` 是 C 语言专门用于表示数组大小和数量的无符号类型。

#### **③ 为什么需要这两个成员？**

对象字典查找时，需要知道：

```
从哪里开始查找？
一共有多少条？
```

所以可以这样遍历：

```c
for (i = 0; i < table->count; ++i) {
    if (table->entries[i].index == index &&
        table->entries[i].subindex == subindex) {
        /* 找到对象 */
    }
}
```

这里：

```
table->entries[i]
```

访问第 `i` 个对象条目。

```
table->count
```

限制查找范围，避免访问数组之外的内存。

#### **④ `co_od_entry_t` 和 `co_od_table_t` 的区别**

```
co_od_entry_t
    → 一条对象记录
```

例如：

```
0x6200:01 数字输出
co_od_table_t
    → 多条对象记录组成的对象字典表
```

例如：

```
0x6000:01
0x6200:01
0x6401:01
0x6401:02
```

可以记成：

```
entry = 一行
table = 多行组成的表
```

### 8：对象字典对外提供的三个主要接口

```c
/**
 * 用途：根据 Index 和 Sub-index 查找对象条目。
 * 返回：找到时通过 entry 输出地址；未知对象返回 CO_ERR_OD_NOT_FOUND。
 */
co_status_t co_od_find(const co_od_table_t *table, uint16_t index,
                       uint8_t subindex, const co_od_entry_t **entry);

/**
 * 用途：读取对象值，并检查输出指针和长度。
 * 说明：ro 和 rw 对象都允许读取；数据按 CANopen 小端顺序交给回调。
 */
co_status_t co_od_read(const co_od_entry_t *entry, uint8_t *data,
                       uint8_t data_length);

/**
 * 用途：检查权限、状态、长度和值范围后写入对象。
 * 说明：write_preop_only 对象只有在 CO_NMT_PRE_OPERATIONAL 时允许写入。
 */
co_status_t co_od_write(const co_od_entry_t *entry, co_nmt_state_t state,
                        const uint8_t *data, uint8_t data_length);

```

这三个函数是对象字典对外提供的三个主要接口：

```c
co_od_find  → 查找对象
co_od_read  → 读取对象
co_od_write → 写入对象
```

#### co_od_find：

```c
co_status_t co_od_find(
    const co_od_table_t *table,
    uint16_t index,
    uint8_t subindex,
    const co_od_entry_t **entry
);
```

它根据：

```
Index
Sub-index
```

在对象字典表中查找对应的对象条目。

##### 第一个参数含义：

```
const co_od_table_t *table
```

对象字典表的地址。函数只读取这张表，不修改表内容。

##### 第二个参数：

uint16_t index ，表示要查找的对象索引，例如：0x6200

##### 第三个参数：

uint8_t subindex，表示要查找的子索引，例如：0x01

两者组合起来就是：0x6200:01

##### 最后一个参数：const co_od_entry_t **entry 二重指针

调用时常这样写

```c
const co_od_entry_t *found = NULL;

co_od_find(&table, 0x6200, 0x01, &found);
```

假设内存关系如下：

```c
found 变量本身位于地址 0x1000
found 当前保存的内容是 NULL
```

那么：

```c
found   = NULL
&found  = 0x1000
```

found 对应的变量类型是co_od_entry_t *

其地址对应的变量类型是co_od_entry_t **

因为found 创建出来的目的是存我们要找的对象条目的地址。

然后再取一个指针，就是存着found这个变量的地址，二级指针很好理解，就是指向指针的指针。

所以我们传参数进去就是传&found。

然后是.c函数的实现

```c
co_status_t co_od_find(const co_od_table_t *table,
                       uint16_t index,
                       uint8_t subindex,
                       const co_od_entry_t **entry)
{
    size_t i;

    if (table == NULL || entry == NULL) {
        return CO_ERR_ARGUMENT;
    }

    *entry = NULL;

    if (table->entries == NULL && table->count != 0u) {
        return CO_ERR_ARGUMENT;
    }

    for (i = 0u; i < table->count; ++i) {
        if (table->entries[i].index == index &&
            table->entries[i].subindex == subindex) {
            *entry = &table->entries[i];
            return CO_OK;
        }
    }

    return CO_ERR_OD_NOT_FOUND;
}
```

函数的作用是找到对象条目的地址，存入found中。

形参我们已经传入found 的地址，也就是entry=&found

函数中有*entry = NULL，取 *号的作用就是解引用， *（entry）的意思就是  *  （&found），即变量found

没找到对象条目的地址时，*entry = NULL 就是found=NULL

当找到对象条目的地址时 ，就执行*entry = &table->entries[i]; 把对象条目的地址赋值给found 

补充

```c
笔记中只需要调整两个细节。
① 类型要保留 const：
found   的类型：const co_od_entry_t *
&found  的类型：const co_od_entry_t **
这里 const 限制的是通过指针修改对象条目的内容，不妨碍修改 found 保存的地址。
② *entry = NULL 是查找前执行，不是没找到以后才执行：
*entry = NULL;  /* 先把外面的 found 清空 */
随后：
- 找到了：执行 *entry = &table->entries[i];，让 found 保存条目地址。
- 没找到：found 保持 NULL，返回 CO_ERR_OD_NOT_FOUND。
你这段推导完全正确：
entry = &found;

/* 因此 */
*entry  相当于  *(&found)，也就是 found
所以关键赋值：
*entry = &table->entries[i];
对调用者来说，效果就是：
found = &table.entries[i];
最后注意区分两份结果：
return 返回值 → 告诉你查找是否成功
found        → 保存找到的对象条目地址
拿到 CO_OK 后，就可以通过 found->index、found->type 等访问该条目的信息了。
```

#### co_od_read：

```c
co_status_t co_od_read(
    const co_od_entry_t *entry,
    uint8_t *data,
    uint8_t data_length
);
```

##### 第一个参数  ：const co_od_entry_t *entry

按照刚才的方法拆：

```c
co_status_t co_od_read(
    const co_od_entry_t *entry,
    uint8_t *data,
    uint8_t data_length
);
```

这说明：

> `entry` 是一个指针。

也就是：

> `entry` 里面存放的是一个 `co_od_entry_t` 变量的地址。

例如前面：

```c
const co_od_entry_t *found = NULL;

co_od_find(&table, 0x6401, 0x01, &found);
```

查找成功后：

```
found → 0x6401:01 对象条目
```

读取时传入：

```c
co_od_read(found, data, 2); //此处found存着对象条目0x6401:01的地址
```

进入函数后：

```
entry → 指向 0x6401:01 条目
```

因此函数可以读取：

```
entry->type
entry->length
entry->read
entry->user
```

那 `const` 是什么意思？

```
const co_od_entry_t *entry
```

意思是：

> `entry` 指向的 `co_od_entry_t` 数据，在这个函数里面不能通过 `entry` 修改。

例如：

```
entry->index
```

可以读。

但是：

```
entry->index = 0x6000;
```

不允许。

所以：

```
const co_od_entry_t *entry
        ↓
指向 co_od_entry_t
        ↓
通过这个指针只能读，不能改
```

#####  第二个参数：uint8_t *data

这个就非常简单。

看到：

```
*
```

直接想到：

> **指针 → 地址**

所以：

```
uint8_t *data
```

意思是：

> `data` 是一个指针，它里面保存的是 `uint8_t` 数据的地址。

例如：

```
uint8_t buffer[4];
```

调用：

```
co_od_read(&obj, buffer, 4);
```

数组名：

```
buffer
```

在这里会变成指向第一个元素的地址。

可以粗略理解为：

```
buffer
  ↓
┌────┬────┬────┬────┐
│ 11 │ 22 │ 33 │ 44 │
└────┴────┴────┴────┘
  ↑
  │
 data
```

所以这个参数的目的通常就是：

> **让 `co_od_read()` 把读取到的数据写到调用者提供的内存里。**

例如函数内部可能有：

```
data[0] = 0x12;
data[1] = 0x34;
```

那么调用者的：

```
buffer
```

里面就会得到：

```
12 34
```

这就是为什么这里不能简单传一个普通变量。

##### 第三个参数：uint8_t data_length

这里没有 `*`。

所以：

```
uint8_t
   ↓
普通变量

data_length
   ↓
参数名
```

调用：

```
co_od_read(&obj, buffer, 4);
```

这里的：

```
4
```

就是直接传一个数值。

也就是：

```
data_length = 4
```

它告诉函数：

> `data` 指向的缓冲区有多长，或者本次需要处理多少字节。

#### co_od_write ：

它负责把主站提供的数据写入对象。

```c
co_status_t co_od_write(
    const co_od_entry_t *entry,
    co_nmt_state_t state,
    const uint8_t *data,
    uint8_t data_length
);
```

##### 第一个参数：`entry`

```
const co_od_entry_t *entry
```

看到：

```
*
```

所以：

> `entry` 是一个指针，传入的是一个 `co_od_entry_t` 对象的地址。

比如：

```
co_od_entry_t obj;

co_od_write(&obj, ...);
```

这里：

```
&obj
```

就是把 `obj` 的地址传给 `entry`。

而：

```
const co_od_entry_t *entry
```

中的 `const` 表示：

> **这个函数通过 `entry` 只能读取这个对象，不能修改它。**

所以可以先理解成：

```
entry
 ↓
co_od_entry_t 对象
```

------

##### 第二个参数：`state`

```
co_nmt_state_t state
```

这里**没有 `\*`**。

所以：

> `state` 是一个普通变量，直接传值。

例如：

```
co_nmt_state_t state = CO_NMT_OPERATIONAL;
```

调用：

```
co_od_write(&obj, state, ...);
```

就是：

```
state 的值
   ↓
 state参数
```

它表示：

> **当前 CANopen 节点处于什么 NMT 状态。**

例如可能是：

```
Initialization
Pre-operational
Operational
Stopped
```

所以这个函数写对象字典的时候，需要知道：

> **当前设备处于什么状态。**

因为不同对象可能规定了不同 NMT 状态下是否允许写入。

------

##### 第三个参数：`data`

这个是今天最值得你注意的：

```
const uint8_t *data
```

先忽略 `const`：

```
uint8_t *data
```

看到 `*`：

> `data` 是一个指针，里面保存的是 `uint8_t` 数据的地址。

比如：

```
uint8_t buffer[4] = {0x11, 0x22, 0x33, 0x44};
```

调用：

```
co_od_write(&obj, state, buffer, 4);
```

可以理解成：

```
buffer
 ↓
┌────┬────┬────┬────┐
│ 11 │ 22 │ 33 │ 44 │
└────┴────┴────┴────┘
  ↑
  │
 data
```

所以 `data` 指向的是：

```
要写入对象字典的数据
```

------

##### 为什么这里又有一个 `const`？

这里：

```
const uint8_t *data
```

和刚才：

```
const co_od_entry_t *entry
```

其实是**同一个道理**。

意思都是：

> **函数可以通过这个指针读取数据，但是不能通过这个指针修改数据。**

例如：

```
data[0]
```

可以读：

```
uint8_t x = data[0];
```

但是：

```
data[0] = 0x55;
```

不允许。

------

为什么 `write()` 的 `data` 反而是 `const`？

这个地方刚开始可能会觉得奇怪：

> “不是 `co_od_write` 吗？为什么 data 不能写？”

因为这里的“write”是：

```
data
 ↓
写入
 ↓
对象字典
```

而不是：

```
data
 ↑
函数往 data 里面写
```

也就是说：

```
调用者提供 data
        │
        │  要写进去的数据
        ↓
co_od_write()
        │
        ↓
对象字典 entry
```

例如：

```
uint8_t data[2] = {0x34, 0x12};

co_od_write(&obj, state, data, 2);
```

意思是：

> 把 `data` 里的 `0x34 0x12` 写入 `obj` 对应的对象。

所以 `co_od_write()` **读取 `data`，然后把它写到对象字典里**。

因此 `data` 是：

```
const uint8_t *data
```

非常合理。

------

、

#####  第四个参数：`data_length`

```
uint8_t data_length
```

没有 `*`。

所以：

> 普通变量，直接传数值。

例如：

```
co_od_write(&obj, state, data, 2);
```

那么：

```
data_length = 2
```

意思就是：

> `data` 中有 2 个字节需要处理。

------

##### 最后把整个函数翻译成人话

```
co_status_t co_od_write(
    const co_od_entry_t *entry,
    co_nmt_state_t state,
    const uint8_t *data,
    uint8_t data_length
);
```

你现在可以翻译成：

> 向指定的对象字典条目 `entry` 写入 `data` 数据，同时根据当前 NMT 状态 `state` 判断是否允许写入，并通过 `data_length` 告诉函数数据有多少字节。

##### 本函数的作用就是：负责把主站提供的数据写入对象

这里的**“主站”不是 STM32**，在你这个 CANopen 项目里，主站通常指**CAN 网络上的控制端/管理端**，而你的 **STM32 F429 设备是从站（CANopen Node）**。

你可以直接对应成：

```
CANopen 网络

        主站
   CAN 上位机 / CANopen Master
          │
          │ CAN
          ↓
     STM32 F429
      从站 Node
```

那 `co_od_write()` 里的“主站提供的数据”是谁提供的？

例如主站想修改 STM32 的某个对象：

```
主站
 │
 │ SDO Write
 │
 │ “把 0x1234 写入 0x2000:01”
 ↓
STM32
 │
 ↓
co_od_write()
 │
 ↓
对象字典 0x2000:01
```

所以这里：

> 主站提供的数据 = CANopen 主站通过 SDO 发给 STM32 的数据。

##### 上位机控制led状态变化链路

```c
CAN 上位机
    ↓
发送 SDO 写请求
    ↓
SDO 服务解析 Index、Sub-index 和数据
    ↓
查找对象字典条目
    ↓
调用 co_od_write()
    ↓
执行对象的 write 回调
    ↓
更新数字输出变量
    ↓
HAL/GPIO 设置 PB0～PB3
    ↓
板载 LED 状态改变
例如：
上位机写入 0x6200:01 = 0x05
0x05 的二进制是：
0000 0101
对应：
bit0 → DO1
bit1 → DO2
bit2 → DO3
bit3 → DO4
因此：
DO1 = 1
DO2 = 0
DO3 = 1
DO4 = 0
最终由硬件层把这些逻辑状态转换成 LED 的实际电平。
不过当前阶段 2 只完成了：
对象字典查找、权限检查、长度检查、范围检查和回调接口
SDO 报文解析会在阶段 5 实现，真实 GPIO 控制会在后面的 STM32 硬件阶段实现。
```
