xiaoyangxianshen664/CANopen_IO_Node/项目完成各阶段对应笔记/阶段3/阶段3.md

阶段 3 主要实现：

```c
NMT 命令解析
    ├── Start → Operational
    ├── Stop → Stopped
    ├── Enter Pre-operational
    ├── Reset Node
    └── Reset Communication

Boot-up 报文
    └── 节点启动后发送 0x700 + Node-ID，数据 00
```

届时会把现在阶段 1 的：

```
co_classify_rx()
```

和新的 NMT 处理逻辑连接起来：

```c
收到 CAN 帧
    ↓
阶段 1：分类为 CO_RX_NMT
    ↓
阶段 3：解析命令并修改 ctx->state
    ↓
必要时通过 co_send() 发送 Boot-up 或状态相关报文
```
