xiaoyangxianshen664/CANopen_IO_Node/项目完成各阶段对应笔记/阶段3/阶段3（co_nmt.h）.md

# 解析：

## 1：NMT命令枚举

```c
typedef enum
{
    CO_NMT_START = 0x01,              // 进入 Operational状态
    CO_NMT_STOP = 0x02,               // 进入 Stopped状态
    CO_NMT_ENTER_PREOP = 0x80,        // 进入 Pre-operational状态
    CO_NMT_RESET_NODE = 0x81,         // 重新初始化并发送 Boot-up（节点复位）
    CO_NMT_RESET_COMMUNICATION = 0x82 // 复位通信部分并发送 Boot-up（通信复位）
} co_nmt_command_t;
```

这个枚举用于表示“主站发给节点的 NMT 命令”

可以拆成三部分理解。

#### 第一部分：

```c
typedef enum {
    ...
} co_nmt_command_t;
```

`enum` 定义一组有名字的整数常量；`typedef` 给这个枚举类型起别名 `co_nmt_command_t`。

以后可以这样声明变量：

```c
co_nmt_command_t command;
```

这个变量用于保存一条 NMT 命令，例如：

```
command = CO_NMT_START;
```

它实际保存的数值就是：

```
command == 0x01
```

#### 第二部分：

这五个枚举成员对应 CANopen NMT 报文中的 `Data[0]`：

| 枚举名称 | 数值 | 含义 | 节点状态变化 |
| --- | --- | --- | --- |
| `CO_NMT_START` | `0x01` | 启动节点 | 进入 `Operational` |
| `CO_NMT_STOP` | `0x02` | 停止节点 | 进入 `Stopped` |
| `CO_NMT_ENTER_PREOP` | `0x80` | 进入预操作状态 | 进入 `Pre-operational` |
| `CO_NMT_RESET_NODE` | `0x81` | 节点复位 | 重新初始化并发送 Boot-up |
| `CO_NMT_RESET_COMMUNICATION` | `0x82` | 通信复位 | 复位通信部分并发送 Boot-up |

例如主站发送：

```c
CAN-ID = 0x000
DLC    = 2
DATA   = 01 01
```

拆开就是：

```
frame.data[0] = 0x01;  // CO_NMT_START
frame.data[1] = 0x01;  // 目标 Node-ID = 1
```

在 `co_nmt.c` 中，后面会通过 `switch` 判断这个命令：

```c
switch (frame->data[0])
{
case CO_NMT_START:
    change_state(nmt, CO_NMT_OPERATIONAL);
    break;

case CO_NMT_STOP:
    change_state(nmt, CO_NMT_STOPPED);
    break;

case CO_NMT_ENTER_PREOP:
    change_state(nmt, CO_NMT_PRE_OPERATIONAL);
    break;
}
```

#### 第三部分：

这里有一个很容易混淆的点：

```c
NMT 命令值 ≠ NMT 状态值
```

例如：

```c
CO_NMT_START              = 0x01
CO_NMT_OPERATIONAL        = 0x05
```

含义不同：

```c
0x01：主站命令——请进入 Operational
0x05：节点状态——当前已经处于 Operational
```

同样：

```
CO_NMT_RESET_NODE = 0x81
```

并不表示节点状态是 `0x81`。它只是告诉节点执行一次节点复位。复位完成后，节点会重新进入初始化流程，发送：

```c
CAN-ID = 0x700 + Node-ID
DLC    = 1
DATA   = 00
```

然后进入 `Pre-operational`。

另外，这几个数值不是程序员自行选择的普通编号，而是 CANopen NMT 协议规定的命令字节。因此接收报文时，代码直接把 `frame->data[0]` 和这些枚举常量比较，就能把原始字节转换成明确的协议含义。

## 2：函数指针

```c
typedef void (*co_nmt_notify_fn)(void *user, co_nmt_state_t state);
```

这句定义的是一个**函数指针类型**，用于保存“状态变化通知回调函数”的地址

`co_nmt_notify_fn` 是一种函数指针类型。它指向的函数没有返回值，接收两个参数：`void *user` 和 `co_nmt_state_t state`。

要求被指向的函数必须符合这个形式：

```c
void 某个函数(void *user, co_nmt_state_t state)
{
    // 处理状态变化
}
```

测试代码中定义的：

```c
static void notify(void *user, co_nmt_state_t state)
{
    fake_t *f = user;
    ++f->notifications;
    f->state = state;
}
```

这个函数的函数类型正好符合：

```c
void (*)(void *, co_nmt_state_t)
```

## 3：保存 **NMT 模块运行时需要的全部上下文**结构体

```c
typedef struct
{
    co_context_t *node;
    co_device_od_t *device;
    co_nmt_notify_fn notify;
    void *user;
} co_nmt_t;
typedef struct { ... } co_nmt_t;` 的意思是：

 定义一个结构体类型，并把它命名为 `co_nmt_t`。

```

这段定义的是一个结构体类型，用来保存 **NMT 模块运行时需要的全部上下文**

### 1. `co_context_t *node`

先创建具体变量，再把指针关系连起来。为了避免同名混淆，实际节点变量叫 `my_node`，NMT 变量叫 `my_nmt`。

```
co_context_t my_node = {0};  // 创建一个实际节点上下文
co_nmt_t my_nmt = {0};       // 创建一个NMT上下文
```

`my_node` 里面有阶段 1 定义的这些成员：

```c
my_node.node_id
my_node.state
my_node.tx
my_node.tx_user
//赋值
my_node.node_id = 1;
my_node.state = CO_NMT_PRE_OPERATIONAL;

现在 my_node 保存的是：
my_node
├── node_id = 1
├── state   = CO_NMT_PRE_OPERATIONAL
├── tx      = NULL
└── tx_user = NULL
```

```c
//NMT上下文 结构体my_node 中的第一个子变量co_context_t *node;
```

它是 `co_nmt_t` 中的成员声明，表示：

> `node` 是一个指针成员，可以保存一个 `co_context_t` 变量的地址。

我们让 `my_nmt.node` 保存 `my_node` 的地址：

```c
my_nmt.node = &my_node;
```

对应关系就是：

```
my_nmt                         my_node
┌──────────────────┐           ┌──────────────────────────────┐
│ node = &my_node  │ ────────> │ node_id = 1                  │
└──────────────────┘           │ state = PRE_OPERATIONAL      │
                               │ tx = NULL                    │
                               │ tx_user = NULL               │
                               └──────────────────────────────┘
```

`my_nmt.node` 保存的是地址，没有复制一份 `my_node`。

此时，可以通过这个指针读取原节点的成员：

```c
my_nmt.node->node_id   // 读到1
my_nmt.node->state     // 读到CO_NMT_PRE_OPERATIONAL
```

也可以通过它修改原节点：

```
my_nmt.node->state = CO_NMT_OPERATIONAL;
```

执行后：

```
my_node.state == CO_NMT_OPERATIONAL
```

因为下面两种写法访问的是**同一个成员**：

```
my_node.state          // 直接通过结构体变量访问
my_nmt.node->state     // 通过指向它的指针访问
```

最后，再接到 `.c` 中常见的写法。假设有一个指针 `nmt`，指向 `my_nmt`：

```
co_nmt_t *nmt = &my_nmt;
```

那么：

```
nmt->node->state = CO_NMT_OPERATIONAL;
```

可以分成两步读：

```c
nmt
 │
 │ nmt->node：取出my_nmt中保存的节点地址
 ▼
&my_node
 │
 │ ->state：访问这个节点的state成员
 ▼
my_node.state
```

所以这三种写法，最终修改的是同一个地方：

```
my_node.state = CO_NMT_OPERATIONAL;

my_nmt.node->state = CO_NMT_OPERATIONAL;

nmt->node->state = CO_NMT_OPERATIONAL;
```

这就是 `co_context_t *node` 的作用：**让 NMT 模块通过保存的地址，访问和修改已经创建好的节点上下文。**

### 2. `co_device_od_t *device`

我们继续只看第二个成员：

```c
co_device_od_t *device;
```

它表示：

> `device` 是一个指针成员，用来保存设备对象字典实例的地址。

先创建三个具体变量：

```c
co_context_t my_node = {0};		
co_device_od_t my_device = {0};
co_nmt_t my_nmt = {0};
```

这里：

```c
my_device
是阶段 2 的实际设备对象字典实例。它里面包含：
my_device.fields   // 每个对象当前保存的值
my_device.entries  // 每个对象的访问描述
my_device.table    // 查找对象时使用的表
```

接着让 NMT 上下文保存它的地址：

```c
my_nmt.device = &my_device;
```

```c
my_nmt                         my_device
┌───────────────────┐          ┌────────────────────────┐
│ device=&my_device │ ───────> │ fields[]               │
└───────────────────┘          │ entries[]              │
                               │ table                  │
                               └────────────────────────┘
```

下面两种写法访问的是同一个对象字典：

```c
my_device.table.count
my_nmt.device->table.count
```

## 

### 3.`co_nmt_notify_fn （notify）`

`notify` 用来保存函数指针

```c
先准备一份应用数据，用来记录“收到多少次通知、最近一次是什么状态”：
typedef struct
{
    unsigned notify_count;
    co_nmt_state_t last_state;
} app_data_t;

然后创建实际变量：
app_data_t my_app = {0};  // 应用数据
co_nmt_t my_nmt = {0};   // NMT上下文

此时我们有两份独立的存储：
my_app
├── notify_count = 0
└── last_state   = 0

my_nmt
├── node   = NULL
├── device = NULL
├── notify = NULL
└── user   = NULL
```

我们编写一个实际的通知函数：

```c
static void app_on_nmt_state(void *user, co_nmt_state_t state)
{
    app_data_t *app = user;

    app->notify_count++;
    app->last_state = state;
}
```

这个函数的形式符合前面定义的函数指针类型：

```
typedef void (*co_nmt_notify_fn)(void *user,
                               co_nmt_state_t state);
```

因此可以把函数地址保存到 `my_nmt.notify`：

```c
my_nmt.notify = app_on_nmt_state;
```

这句只保存地址，**还没有执行函数**。

```
my_nmt.notify ────> app_on_nmt_state() 函数
```

这里 `notify` 虽然没有直接写成 `*notify`，但它仍是函数指针，因为类型别名 `co_nmt_notify_fn` 已经包含了指针含义。

### 4.`void *user`

保存回调要使用的数据地址。

让它指向刚才创建的 `my_app`：

```c
app_data_t my_app = {0};  // 应用数据
//有 my_nmt.user = &my_app;
```

```c
现在两个成员的关系是：
my_nmt
├── notify ──────> app_on_nmt_state() 函数
│
└── user ────────> my_app
                   ├── notify_count = 0
                   └── last_state   = 0
```

`user` 的类型是 `void *`，因此它能保存 `&my_app`，但没有保留“这是 `app_data_t`”的类型信息。

所以不能直接写：

```
my_nmt.user->notify_count++;  // 错误：void *不知道有哪些成员
```

回调内部需要先用一个具有明确类型的指针接住它：

在 C 语言中，`void *` 可以这样赋给对应的对象指针。此时：

```c
my_nmt.user = &my_app;
//其中user存折地址 &my_app
//进行赋值
app_data_t *app = user;
得到app ──────> my_app
就能通过 app 访问具体成员了。
```

**现在把两者连起来，实际调用一次。**

```
my_nmt.notify(my_nmt.user, CO_NMT_OPERATIONAL);
```

根据前面的赋值：

```c
my_nmt.notify = app_on_nmt_state;
my_nmt.user = &my_app;
```

这次调用相当于：

```c
app_on_nmt_state(&my_app, CO_NMT_OPERATIONAL);
```

进入函数后，具体过程是：

```c
static void app_on_nmt_state(void *user, co_nmt_state_t state)
{
    // user收到&my_app；state收到CO_NMT_OPERATIONAL
    app_data_t *app = user;

    app->notify_count++;       // 修改my_app.notify_count
    app->last_state = state;  // 修改my_app.last_state
}
```

执行结果：

```c
my_app
├── notify_count = 1
└── last_state   = CO_NMT_OPERATIONAL
```

这里没有创建新的应用数据，修改的仍然是原来的 `my_app`。

### 最后对应到 `.c` 中的写法：

```
co_nmt_t *nmt = &my_nmt;
```

那么：

```
nmt->notify(nmt->user, state);
```

就是：

```
my_nmt.notify(my_nmt.user, state);
```

也就是：

```
app_on_nmt_state(&my_app, state);
```

实际代码会先检查函数指针：

```c
if (nmt->notify != NULL)
    nmt->notify(nmt->user, state);
```

这样调用者不需要通知、把 `notify` 设置为 `NULL` 时，就不会调用空指针。我们这个示例的回调需要访问 `my_app`，因此配套的 `user` 必须指向有效且仍然存在的 `app_data_t` 变量。

这两个成员可以这样记：

```
my_nmt.notify = app_on_nmt_state;  // 状态变化时，调用谁？
my_nmt.user = &my_app;            // 调用时，把谁的数据地址交给它？
```
