xiaoyangxianshen664/CANopen_IO_Node/images/1：pcb及焊接/1：原理图及pcb设计.png

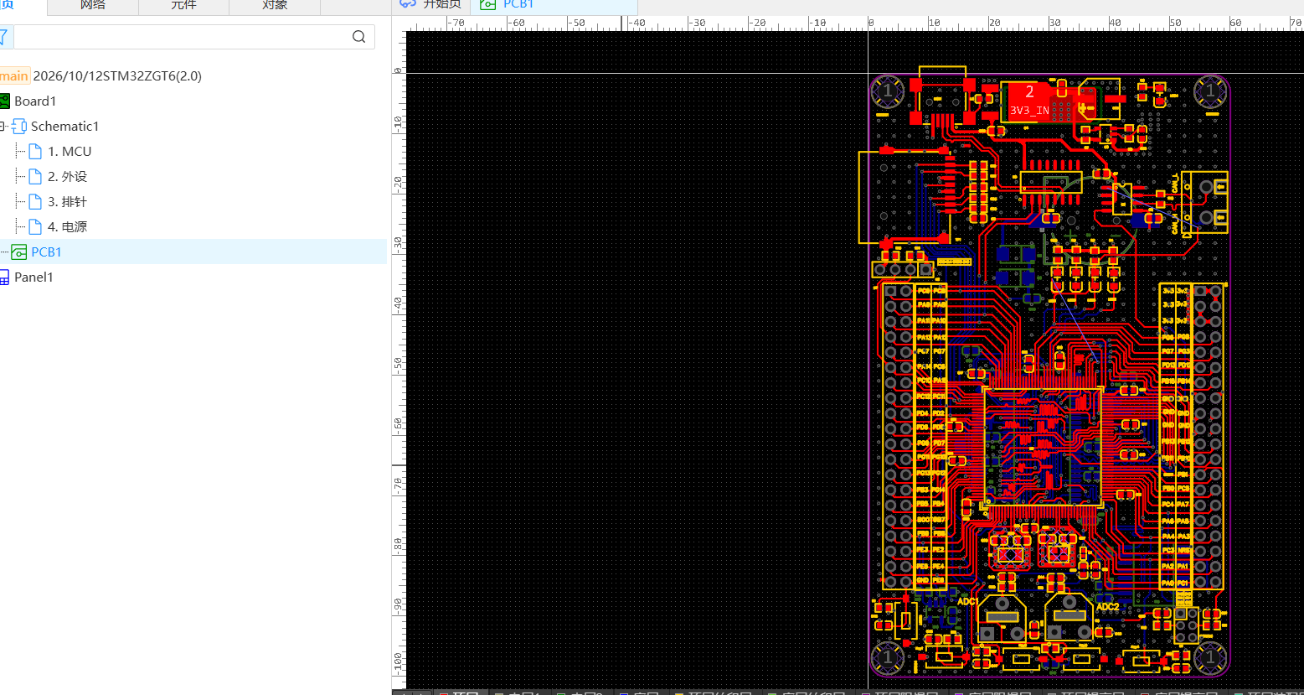
images/1：pcb及焊接/1：原理图及pcb设计.png
