xiaoyangxianshen664/CANopen_IO_Node/images/1：pcb及焊接/2：pcb对应3D视图.png

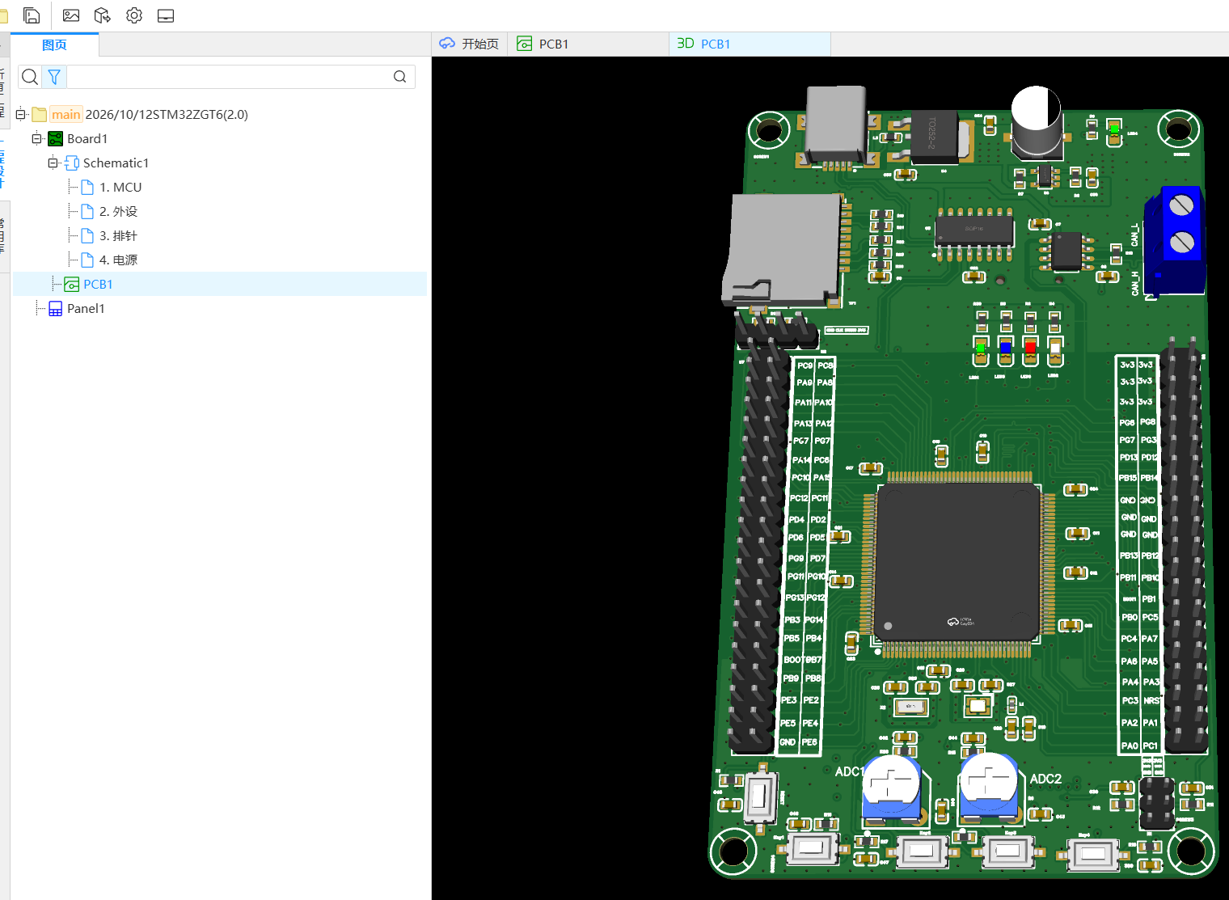
images/1：pcb及焊接/2：pcb对应3D视图.png
