xiaoyangxianshen664/CANopen_IO_Node/images/1：pcb及焊接/3：实物裸板.png

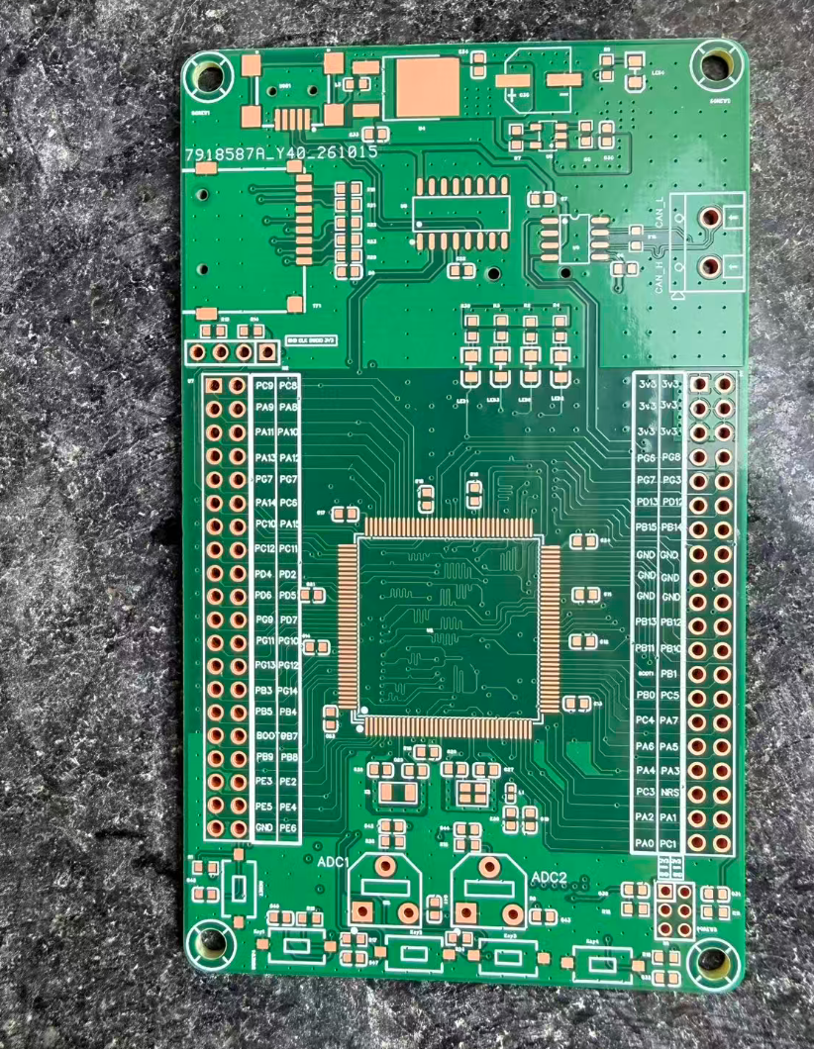
images/1：pcb及焊接/3：实物裸板.png
