xiaoyangxianshen664/CANopen_IO_Node/images/1：pcb及焊接/4：焊接电源及芯片.png

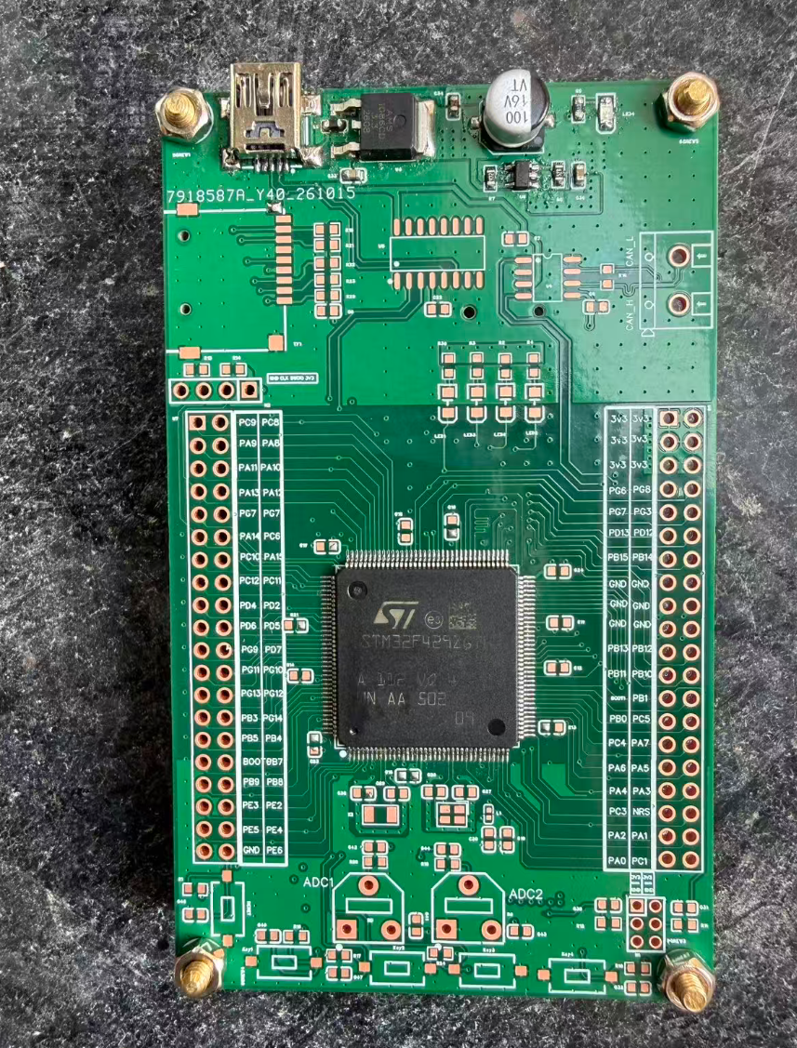
images/1：pcb及焊接/4：焊接电源及芯片.png
