xiaoyangxianshen664/CANopen_IO_Node/images/1：pcb及焊接/5：焊接完成开始测试.png

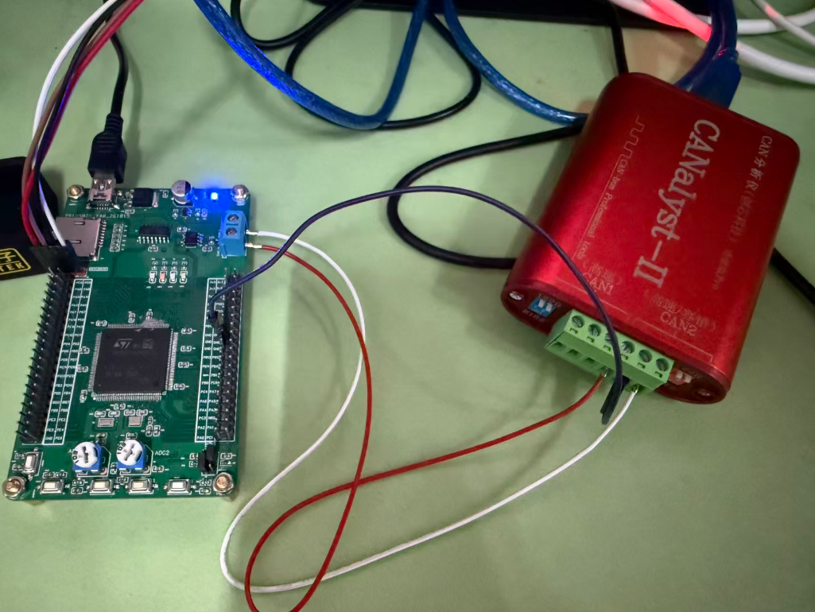
images/1：pcb及焊接/5：焊接完成开始测试.png
