xiaoyangxianshen664/CANopen_IO_Node/images/2：软件代码测试/1：设备正常启动.png

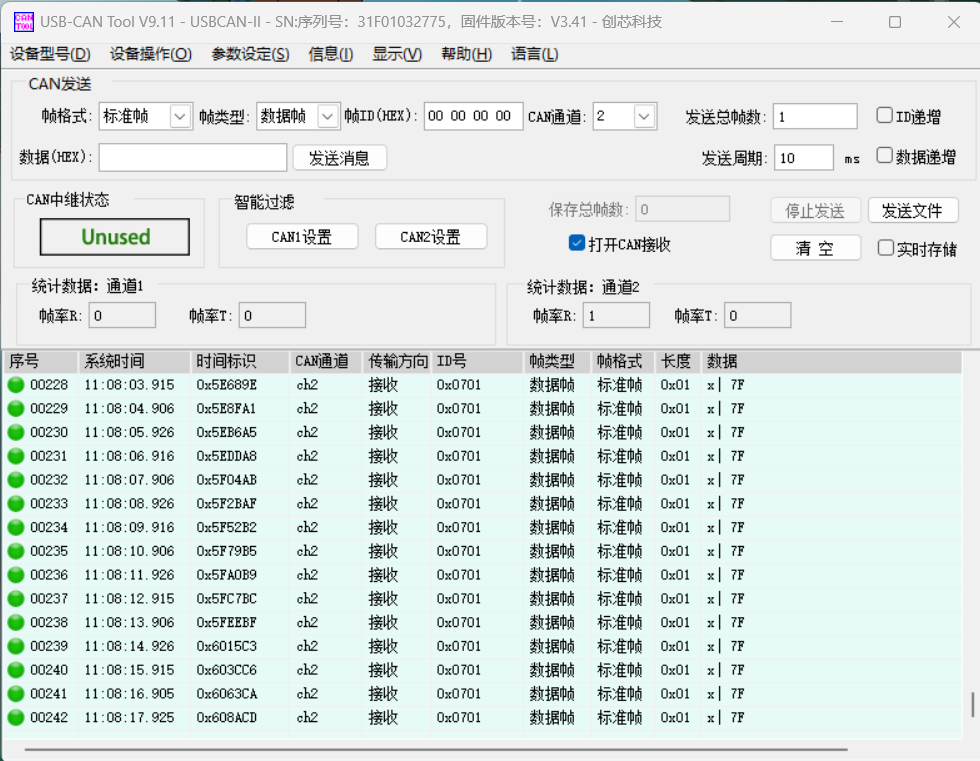
images/2：软件代码测试/1：设备正常启动.png
