xiaoyangxianshen664/CANopen_IO_Node/images/2：软件代码测试/3.1控制灯led1亮.png

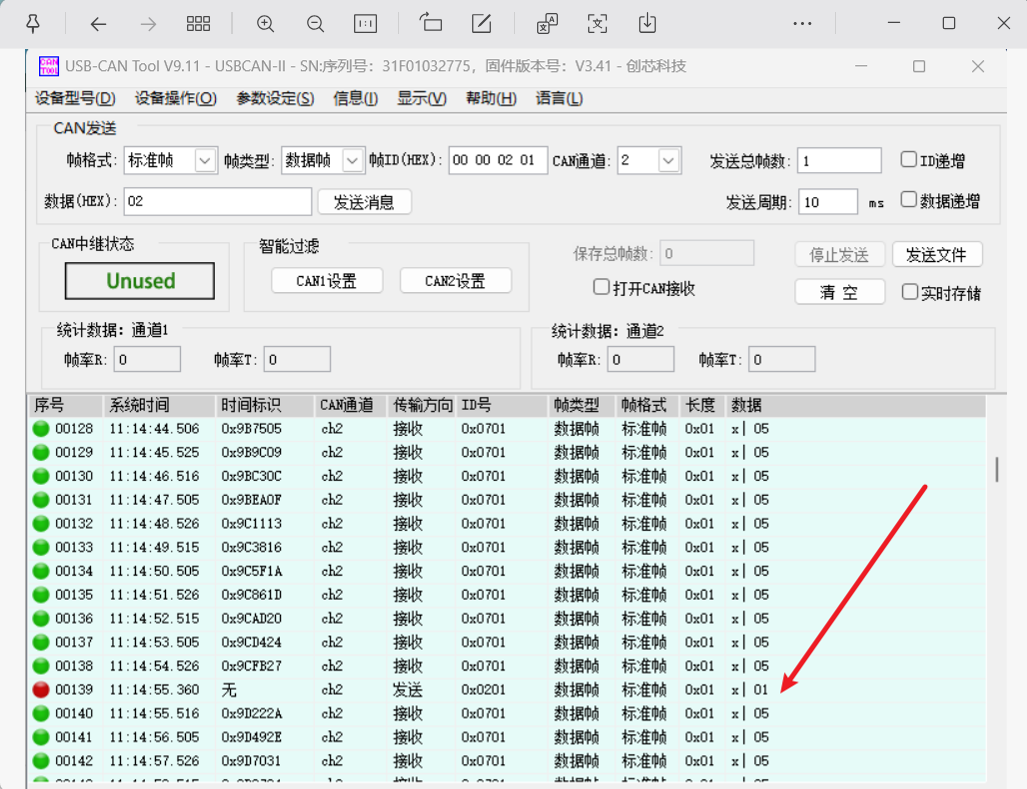
images/2：软件代码测试/3.1控制灯led1亮.png
