xiaoyangxianshen664/CANopen_IO_Node/images/2：软件代码测试/3.2对应灯led2亮的实物图.png

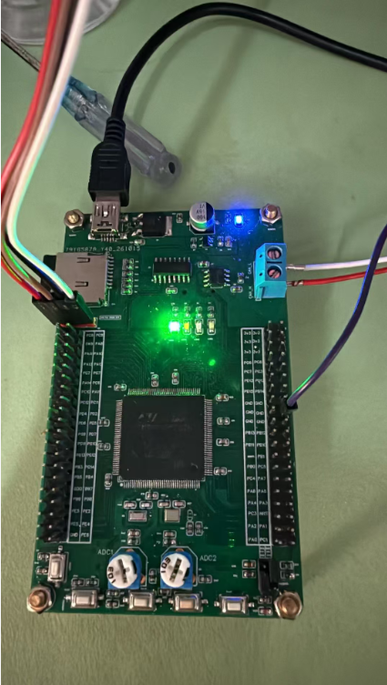
images/2：软件代码测试/3.2对应灯led2亮的实物图.png
