xiaoyangxianshen664/CANopen_IO_Node/images/2：软件代码测试/3.4对应led4亮.png

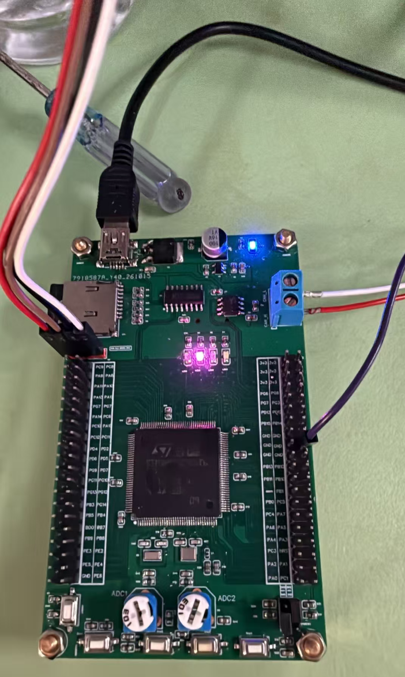
images/2：软件代码测试/3.4对应led4亮.png
