xiaoyangxianshen664/CANopen_IO_Node/images/2：软件代码测试/3.5发送00控制所有灯灭.png

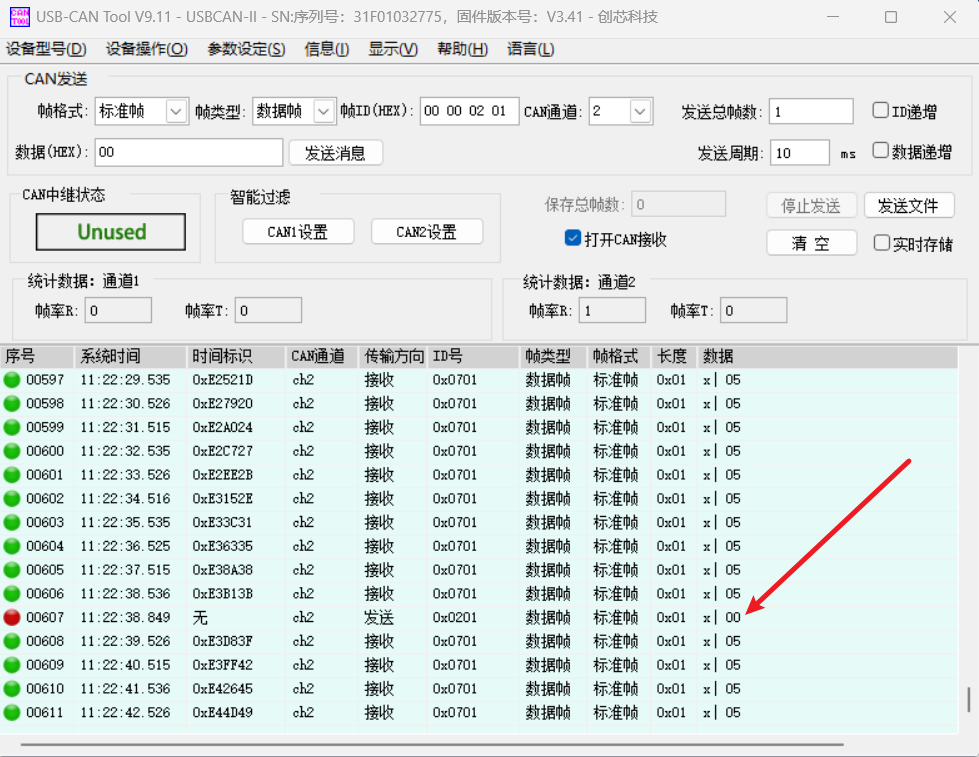
images/2：软件代码测试/3.5发送00控制所有灯灭.png
