xiaoyangxianshen664/CANopen_IO_Node/images/2：软件代码测试/4.2：按下key2.png

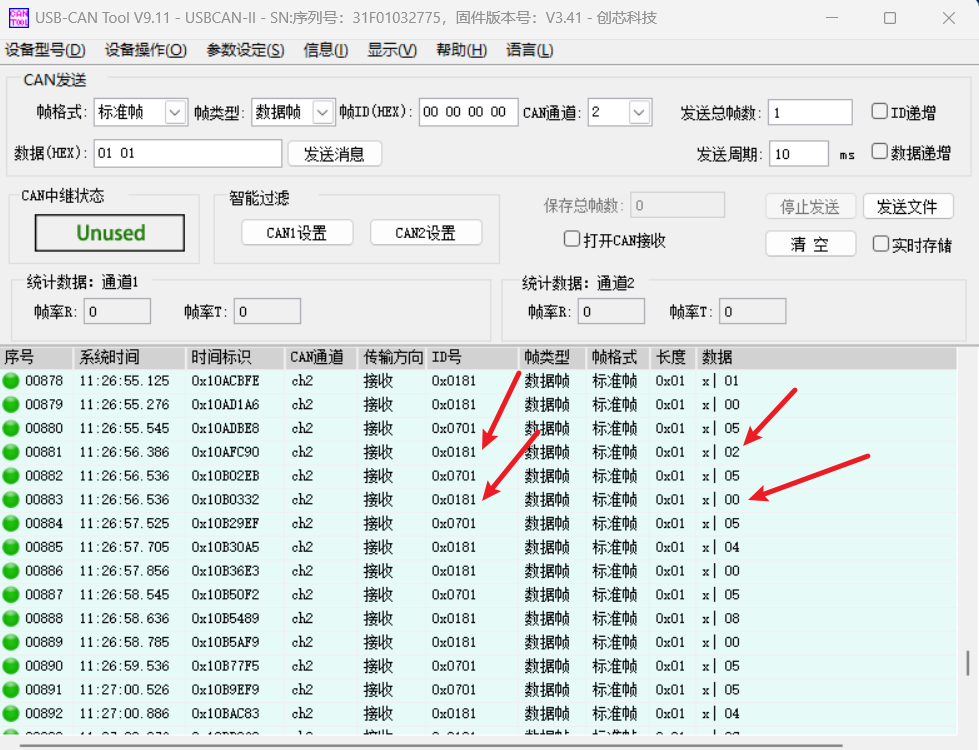
images/2：软件代码测试/4.2：按下key2.png
