xiaoyangxianshen664/CANopen_IO_Node/images/2：软件代码测试/4.3：按下key3.png

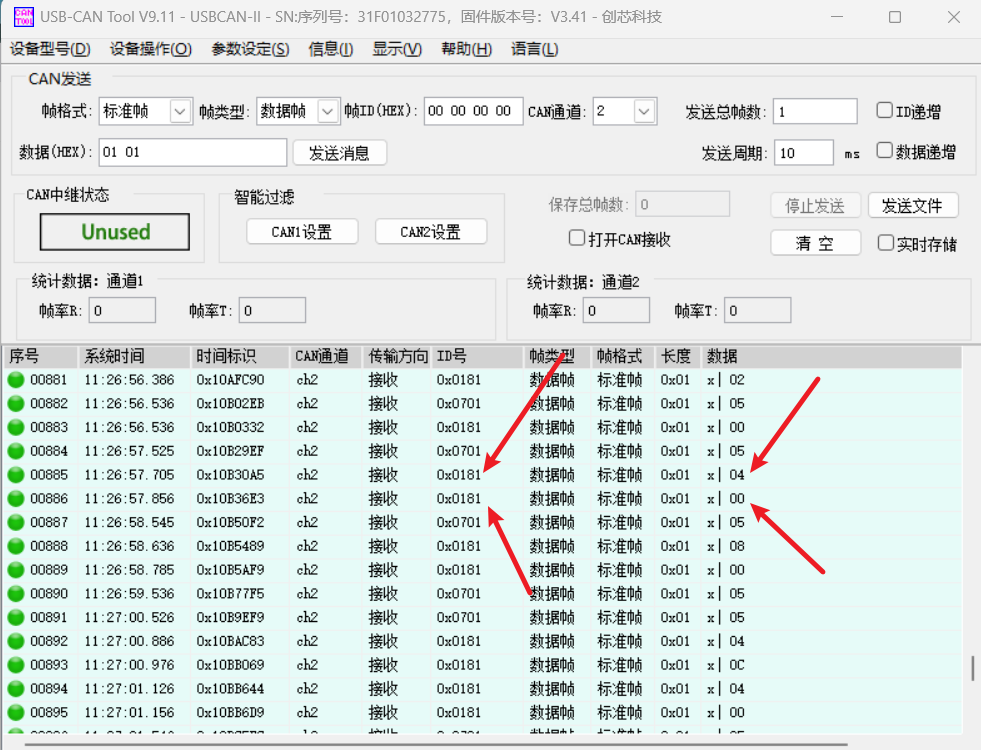
images/2：软件代码测试/4.3：按下key3.png
