xiaoyangxianshen664/CANopen_IO_Node/images/2：软件代码测试/4.4：按下key4.png

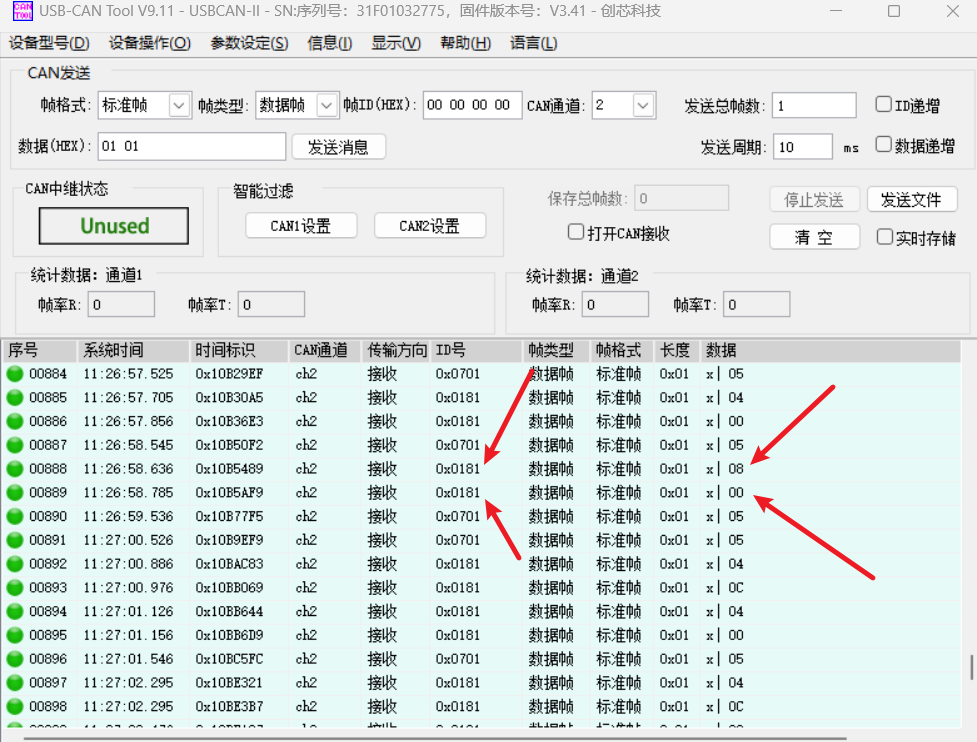
images/2：软件代码测试/4.4：按下key4.png
