xiaoyangxianshen664/CANopen_IO_Node/images/2：软件代码测试/4.5组合按下key2和key3.png

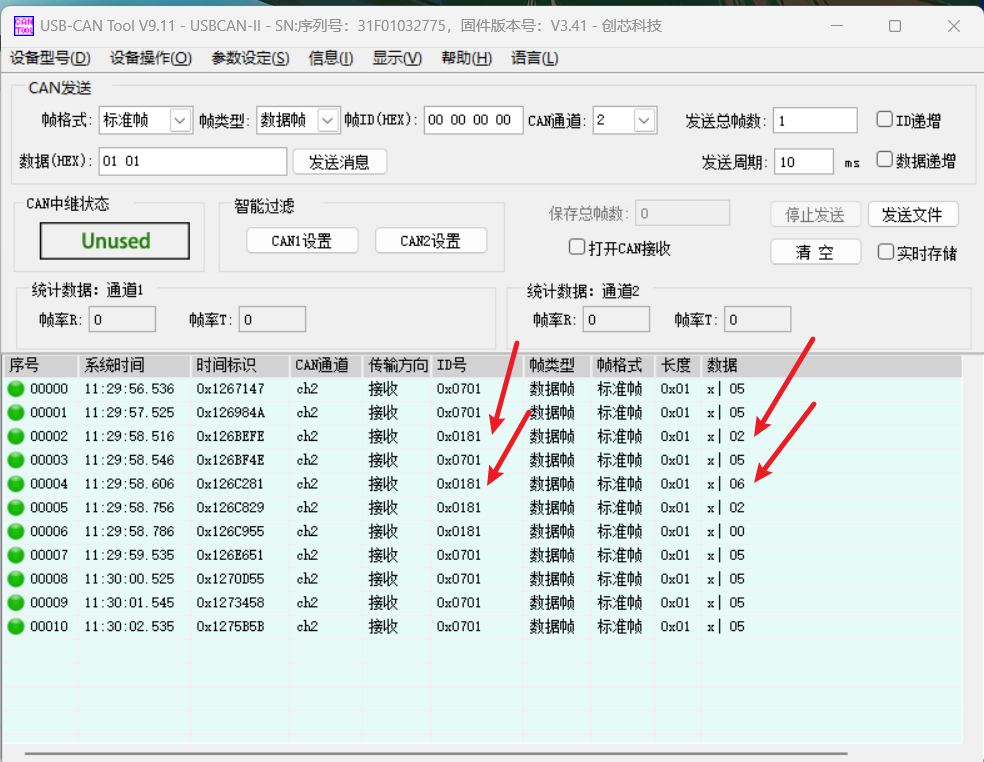
images/2：软件代码测试/4.5组合按下key2和key3.png
