xiaoyangxianshen664/CANopen_IO_Node/images/2：软件代码测试/5.2：SDO读取ADC2采样值及拧动后的采样值变化有效读取到.png

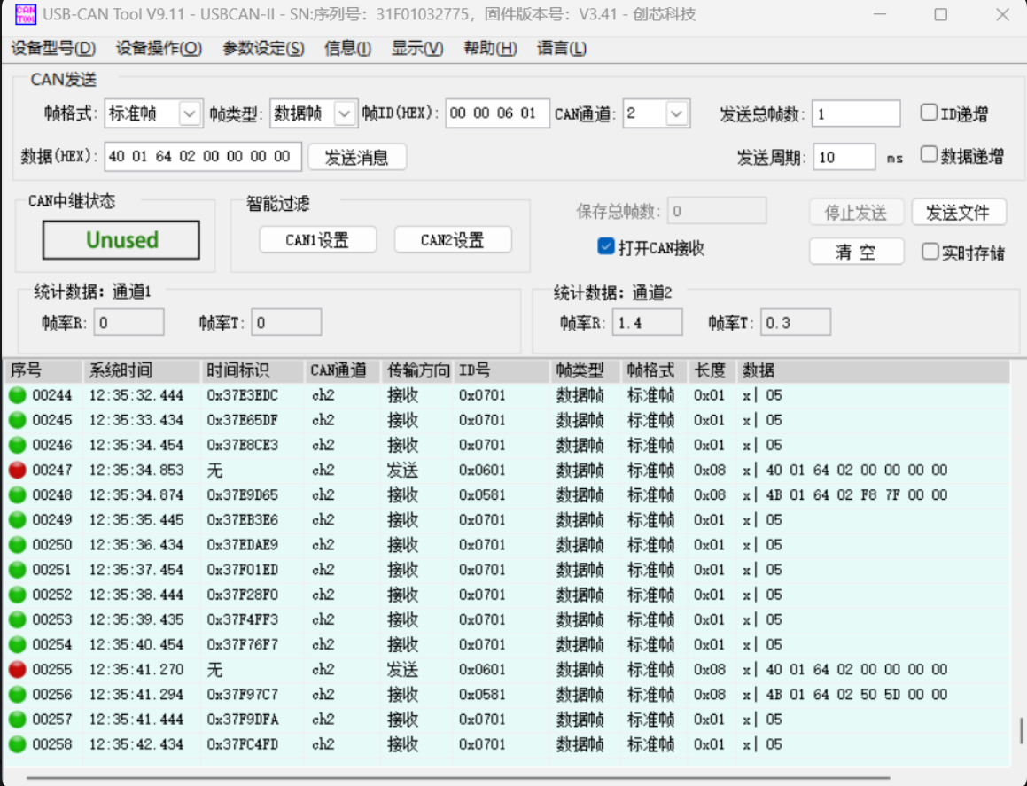
images/2：软件代码测试/5.2：SDO读取ADC2采样值及拧动后的采样值变化有效读取到.png
