xiaoyangxianshen664/CANopen_IO_Node/images/2：软件代码测试/5.3：SDO 写入控制 DO 点亮 LED.png

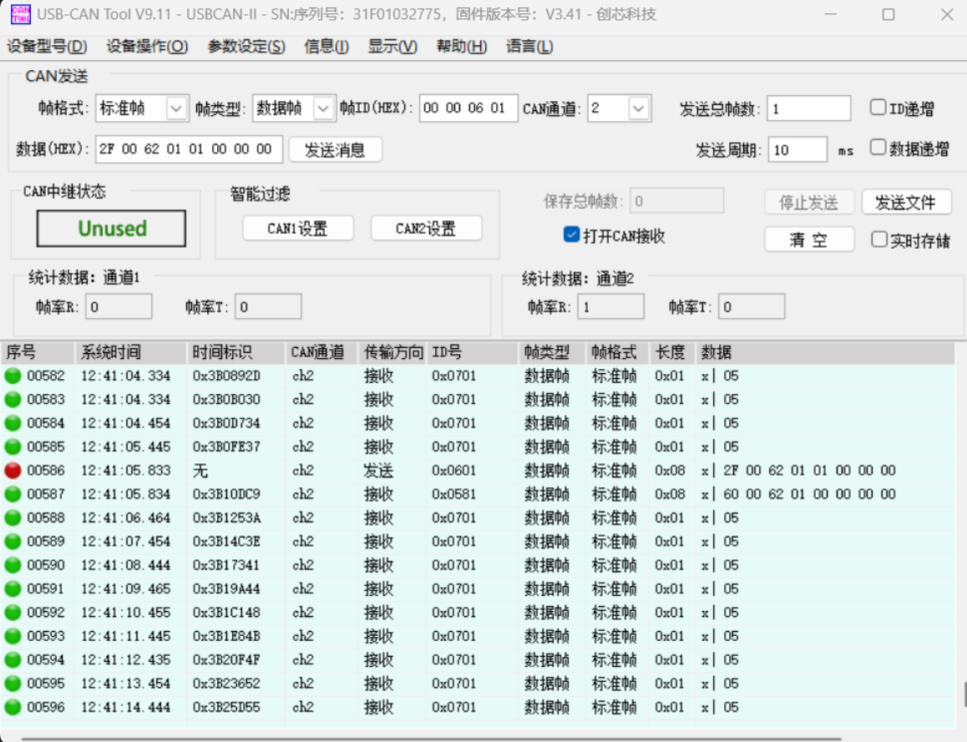
images/2：软件代码测试/5.3：SDO 写入控制 DO 点亮 LED.png
