xiaoyangxianshen664/CANopen_IO_Node/images/2：软件代码测试/5.3：SDO写入控制DO点亮led实物图.png

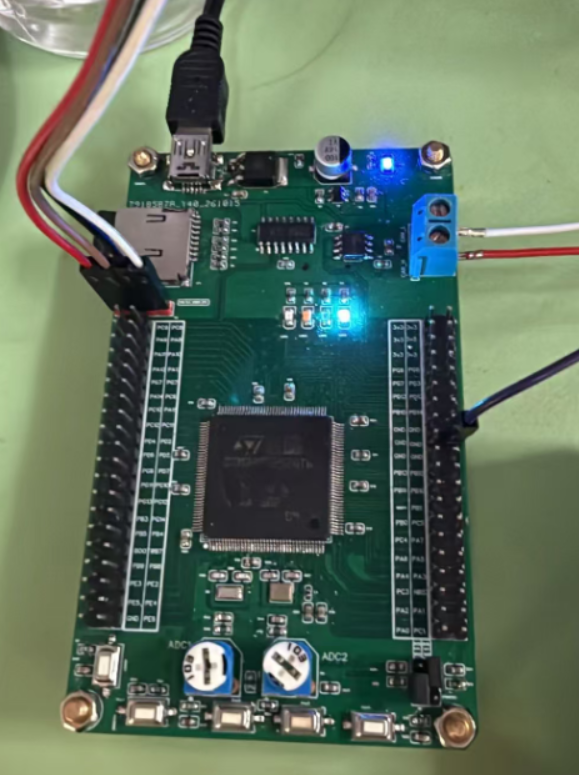
images/2：软件代码测试/5.3：SDO写入控制DO点亮led实物图.png
