xiaoyangxianshen664/CANopen_IO_Node/images/2：软件代码测试/5.4：SDO写入控制DO熄灭led实物图.png

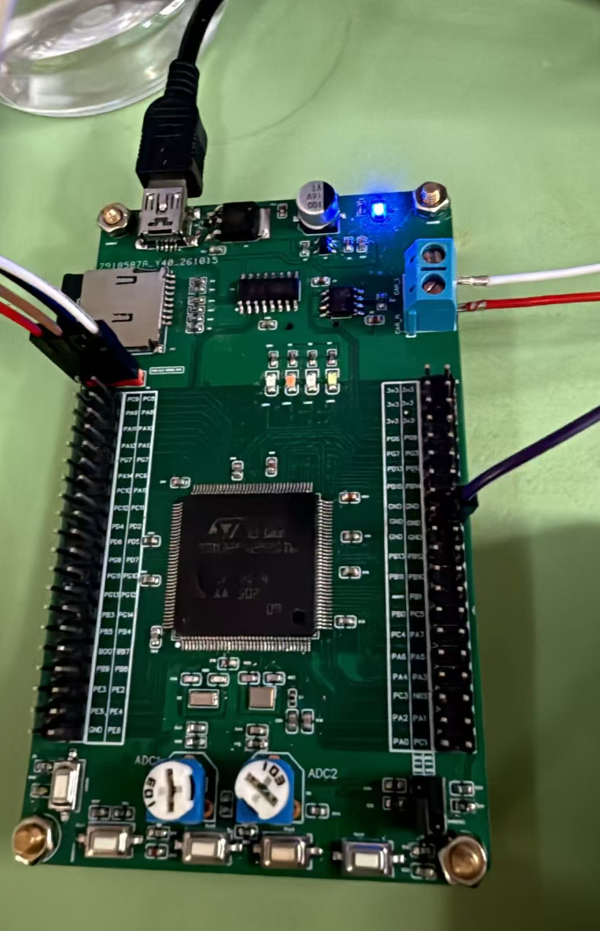
images/2：软件代码测试/5.4：SDO写入控制DO熄灭led实物图.png
