xiaoyangxianshen664/CANopen_IO_Node/images/2：软件代码测试/6.1：测试NMT的stop状态（先SDO打开led灯）.png

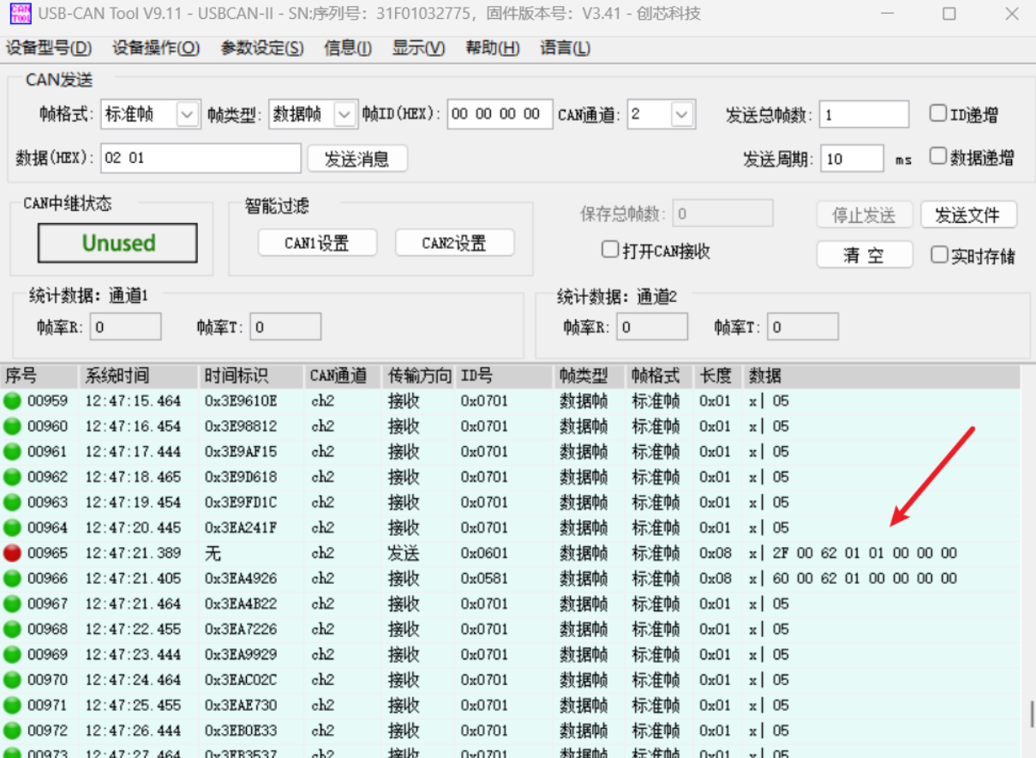
images/2：软件代码测试/6.1：测试NMT的stop状态（先SDO打开led灯）.png
