xiaoyangxianshen664/CANopen_IO_Node/images/2：软件代码测试/6.3：系统心跳上报nmt状态至04.png

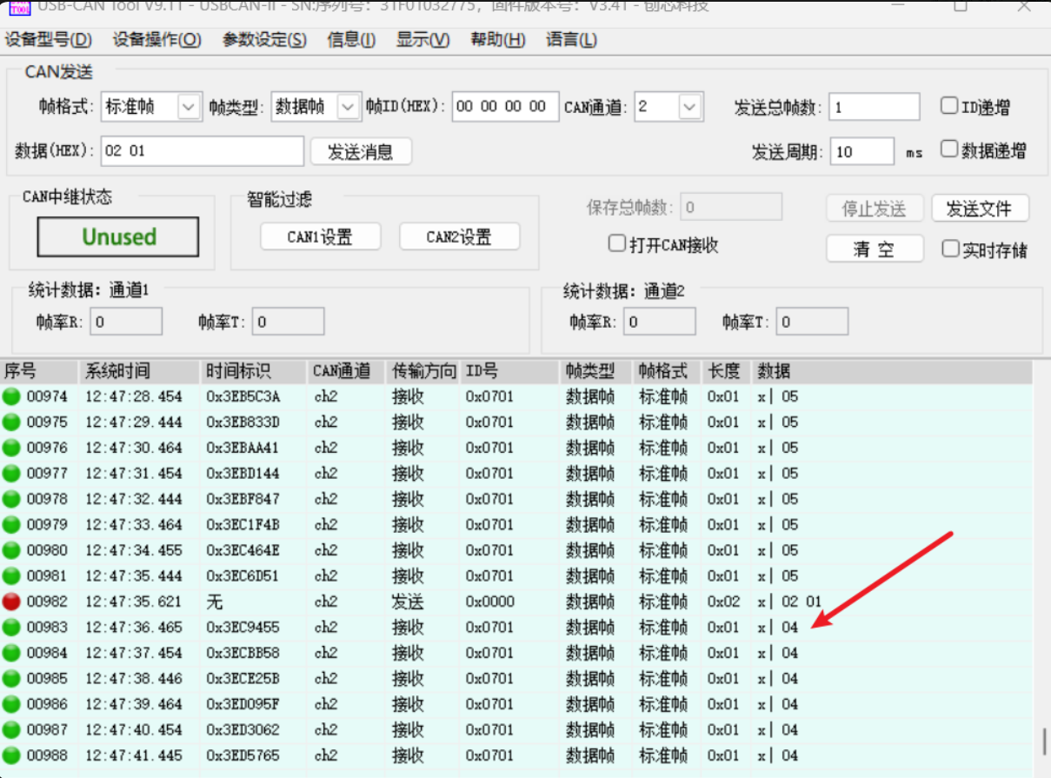
images/2：软件代码测试/6.3：系统心跳上报nmt状态至04.png
