xiaoyangxianshen664/CANopen_IO_Node/images/2：软件代码测试/2：节点已进入 Operationa.png

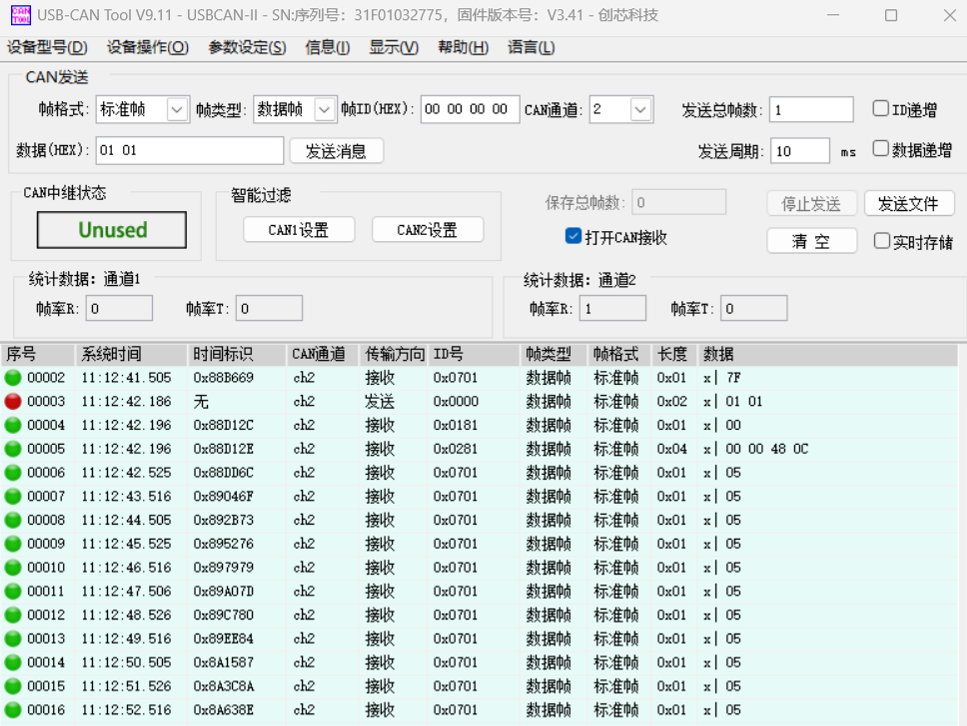
images/2：软件代码测试/2：节点已进入 Operationa.png
