xiaoyangxianshen664/CANopen_IO_Node/(commit log)

2026-09-18 Start stage 2 object dictionary
2026-09-18 Implement stage 2 object dictionary core
2026-09-24 Complete CANopen stages 1 through 3
2026-10-02 Add STM32F429 CAN BSP
2026-10-03 Complete stage 7 CANopen hardware validation
2026-10-05 Complete stage 8 FreeRTOS and real I/O integration
2026-10-07 Complete stage 9 EMCY reliability and validation
2026-10-07 Complete stage 10 project consolidation
2026-10-07 Mark stage 10 delivery complete
2026-10-24 Add PCB and CANopen test images
